Accelerator6666/Yaesu-FT2D-USBC-charge/hardware/Rev_B/README.md

# FT2D PCB Rev B（JLCPCB 首板工作版，未放行）

检查日期：2026-10-26；KiCad 10.0.7；目标板厂：嘉立创 JLCPCB；目标工艺：4 层 PCB + SMT 代贴片。

> **规则检查已清零，但制造仍 NO-GO。** 本目录可在 KiCad 10 打开；J1/L1 换料、C18 新候选的焊盘调整、GND 回流布线、局部功率铜、U3 四颗标准过孔及 In2 两个局部功率铜岛均已同步，全部 DRC/Parity 通过。**53/53 个 SMT 位号已匹配候选 LCSC 编码，37 种物料均未正式获批**。剩余 3 A 功率/散热审查、JLC 实际供料/兼容性、元器件和装配方向签核尚不能省略。

## 当前可复现检查

```sh
kicad-cli sch erc --format json -o erc_rev_b.json FT2D_PD20V_12V5_3A_评审原理图.kicad_sch
kicad-cli pcb drc --schematic-parity --refill-zones --format json -o drc_rev_b.json FT2D_PD20V_12V5_3A_评审原理图.kicad_pcb
```

| 检查 | 实际结果 | 说明 |
| --- | --- | --- |
| 原理图 ERC | **0** | 仅表示静态 ERC 通过 |
| 异网短路 / 铜间距违规 | **0** | KiCad 本次静态规则检查未发现硬性违规 |
| DRC violations | **0** | U1 已用系统库相同 29 焊盘封装刷新；局部无效热焊盘连接已处理 |
| DRC unconnected | **0** | 独立顶层 GND 区域通过常规穿孔过孔与内层地面连接，C5 补上局部 GND 逃线 |
| schematic parity | **0** | PCB 与当前 Rev B 原理图一致；DNP 设置同步 |

上述结果按此目录所附 `erc_rev_b.json` 和 `drc_rev_b.json` 为准。**规则检查 0/0/0/0 不是 3 A 载流能力、PD 功能、贴片方向或安全性能的认证。**

## 本轮已核对并替换的 JLC 物料

| 位号 | 新器件及嘉立创料号 | 原厂/焊盘验证 | 装配保留事项 |
| --- | --- | --- | --- |
| **J1** | HRO `TYPE-C-31-M-12`，**C165948** | 标称 **20 V / 5 A**；KiCad 10 标准 `Connector_USB:USB_C_Receptacle_HRO_TYPE-C-31-M-12`；按产品引脚表保持 CC1/CC2、VBUS、GND 网络，中心 `(24.15,42)`，转角 `-90°` | 立创标为 SMT，但带 **4 个穿孔屏蔽固定脚**；必须由 JLC 订单预览确认这种混合结构可贴装及固定脚焊接方式，并确认板边插拔可达性 |
| **L1** | JIERR `SRG1260-100-M`，**C53463013** | **10 µH ±20%**，Isat **14 A typ**，Idc **11 A typ**，DCR **25 mΩ max**；原厂落地尺寸 14.6 mm 总跨距、7.4 mm 焊盘间隙、4.8 mm 焊盘高度，生成 `FT2D:JIERR_SRG1260_100M`；器件高度 **6 mm max** | 数据表只是额定能力，不是开关纹波/温升实测；尤其要确认电台安装净高 |
| **C18** | Panasonic `EEH-ZA1V470P`，**C178639** | 35 V / 47 µF 混合铝电容，**60 mΩ @100 kHz、1.3 A @100 kHz**；与原 EEH-ZL1V470R 的 **60 mΩ** 指标一致；PCB/C18 的封装改为 KiCad `CP_Elec_6.3x5.8`，中心由 `(62,48)` 移至 `(61.5,48)`，保持 pad 1=`/VBUS_SW`、pad 2=`/GND`；替代后 ERC 0、DRC 0、Parity 0 | **温度由原 135°C 降为 105°C**（虽是 10000 h @105°C）；须复核实际环境和热裕量、极性、焊盘尺寸及库存；不能据此自动批准 SMT |

J1 原厂 [PDF](https://datasheet.lcsc.com/datasheet/pdf/9e56b777c022540fcce7c7f67825f55e.pdf?productCode=C165948)，L1 原厂 [PDF](https://datasheet.lcsc.com/datasheet/pdf/970397481256e0f4304d2971057c0f55.pdf?productCode=C53463013)。立创供料库存会变化，投单时须再次确认。

## 主要阻止打板的问题（按优先级）

1. **3 A 功率铜尚未签核**：顶层沿 `/USB_VBUS`、`/VBUS_RAW`、`/VBUS_SW`、`/SW`、`/V12P5`、`/VOUT` 增加 **1.6–2.0 mm 目标宽度**的合并局部铜皮，但异网净距会裁切狭颈；原细线最小仍为 **0.25–0.60 mm**。本轮按照 TI eFuse IN/OUT 加铜和散热过孔建议，在 `In2.Cu` 增加 `/V12P5` **51.54 mm²** 和 `/VOUT` **55.29 mm²** 互不接触的局部铜岛，每网两颗 **0.6/0.3 mm 普通过孔**；两岛均连续并通过 DRC。U3 Pin 5/6 仍存在约 **0.3 mm** 短逃线，**不能宣称全线按 3 A 等效宽度连通**。需复查各路径最窄断面、过孔电流、内层地回流、压降与满载升温。
2. **BUCK 高频布局仍待复核**：U2 `(79,43)`，L1 SW 端 `(83.5,43)`，直距约 **3.7 mm**；输入 C12/C13 高频去耦位置、U2 VIN/PGND 回路、输出电容接地/反馈 Kelvin 路径都须按照 TI 指南审查，SW 追踪铜面积仍可能引入 EMI。
3. **JLC 候选编码齐备，采购/装配未签核**：53 个非 DNP SMT 位号已有 37 个候选 C-code，本地 BOM/CPL 静态比对全通过。**这不等于 JLC SMT 供料实时有货、同外形即可直接替代，或可下单**。F1 `C41342`、C18 `C178639`、C23 `C46550464` 温度/ESR 降额需确认；**R22 已由 101 kΩ 改为嘉立创标注 SMT 的 102 kΩ / `C861068`**，OVLO 标称阈值约从 13.32 V 变为 13.44 V，实际误差/瞬态仍须验证；**C26 已从 100 nF/25 V 改为 2.2 µF/25 V/0603 X7R 候选 `C415535`，但实际 12.5 V DC bias 后容值需核对**；其他 1210 MLCC 需核实 DC 偏压有效电容，0.1% 电阻需复核实际规格；J1 混合 SMT/通孔固定脚需要装配商确认。
4. **SMT 机器贴装仍未确认**：53 个位置与 PCB 坐标已通过本地审计，但 HRO J1 `-90°`、异形功率器件方向、极性电容、贴片取放中心及 KiCad Y 轴符号必须在 JLC 预览中人工核对。
5. **功能级风险**：STUSB4500 NVM 需编程并验 20 V PDO；eFuse 限流、DC-DC 环路、输出线束电台端极性、热和射频噪声尚无实测。

**新增定量初筛（仍未签核）**：按照 PCB 当前 U3 Pad 5/6 和 35 µm 标称顶铜，假设整段 0.2998 mm 原走线独自承载 3A，分别在 90°C 得到约 **54 mW（2.85 mm 输入）/28 mW（1.49 mm 输出）**的铜阻损耗模型值；实际上 pad 与同网铜区有重叠和并联，若实板铜厚偏低或温度更高损耗还会增加，此算法不能计算温升。U3 典型 28.3mΩ R_ON 在 3A 下自身耗散约 **0.255W**，R26=820Ω 按 TI 典型公式电流门限约 **4.07A**，必须用热测、过流试验核查。自动初筛脚本 `../../engineering_tools/screen_rev_b_power_path.py` 以及结果 `../../manufacturing/Rev_B/PREFLIGHT/power_path_screening.json` 可复现。**STUSB4500 出厂 PDO3=20V/1A，且 `POWER_ONLY_ABOVE_5V=0`，不是本项目所需 20V/3A**；详见 `../../manufacturing/Rev_B/PD_NVM_AND_FIRST_POWER_ON_PLAN.md`。可先使用 `../../manufacturing/Rev_B/QUOTE_PREVIEW_ONLY_NOT_RELEASED/` 作 JLC 在线报价/贴装预览，**不可当作正式放行**。

## 已完成的布线/设计动作

- 原评审 PCB 不变；此目录保留 Rev B 的独立原理图、PCB、工程设置和封装库。
- 保持 `POWER_REV_B` netclass 0.6 mm 路由过渡值，同时用 `power_pours_rev_b.py` 增加局部宽铜；**铜宽仍需实体连续性和发热签核**。
- 用两个新物料封装替换 J1/L1，并将 U2 SW 与 L1 SW 缩至约 3.7 mm；全部原走线重建并验证无异网硬短路。
- 已修复 U1 KiCad 系统库封装不一致告警；优先以常规 **0.6/0.3 mm GND 穿孔过孔**保留回流通路，再全板重布线。U1/U2/R25/R26 周边地与 C5 局部地均已接通，未使用未签核的焊盘盲埋孔。GND 特殊热焊盘局部改为实体连接；全板 DRC **0 违规 / 0 未连接**。
- 把两段自动布线占用 `In1.Cu` GND 参考面的 `/VBUS_SW` 导线转到 `In2.Cu`，避免在 Buck 下方切割连续地平面；重新填铜验证 0/0。
- C18 替换候选 Panasonic C178639 的直径更大，PCB/原理图/符号库同步换成 6.3×5.8 mm 封装，左移 0.5 mm 消除 `/BUCK_VCC` 净距冲突；极性和所有静态规则再次通过。**105°C 温度等级待确认**。
- U3 TPS259474A 的 `/V12P5` 和 `/VOUT` 各加 2 颗常规 0.6/0.3 mm 穿孔并连入 In2 局部功率铜皮（`add_u3_power_stitch_rev_b.py`）；分别提供约 **51.54 / 55.29 mm²** 内层扩散面积，远离现有 In1 模拟反馈/ILM 走线，局部形状/孔距经隔离试板迭代到 DRC0。**新增铜不等于已完成 3 A 温升/EMI 验证。**
- 根据 TI TPS25947 的 OUT 端建议把 **C26 从 100 nF/25 V 升级为 2.2 µF/25 V X7R 0603**，Murata 候选 `GRM188Z71E225KE43D` / `C415535`，原 PCB 0603 pad 保持不变，原理图/符号库/原生 BOM/JLC 候选清单同步；偏压有效容值和取放/库存待审。
- **修复贴片坐标漏项**：将 L1、Q1、U2、U3、D1 自定义封装标为 `attr smd`；C11/R14 DNP 排除，实际预览 CPL 为 **53 个位置**。
- 原理图和 PCB 的 DNP 与 BOM 属性一致，PD 协商和电台输出的电气定义未修改。

可审计工具在 `../../engineering_tools/`；未通过 DRC 的局部接地布线实验已从 PCB 与提交文件中移除。

## 投板门槛

- [ ] 全面优化 U2–L1–电容功率环路，宽铜/铜皮与热设计通过工程复核。
- [x] ERC 0、DRC 0 实质违规、**DRC 0 未连接**、Parity 0（KiCad 10.0.7）；工程复查仍另计。
- [ ] U1、U2、U3、Q1、J1、L1 的封装与厂家 land pattern 对照签核。
- [x] **候选** JLC/LCSC 料号覆盖 53/53 SMT 位号；DNP C11/R14、人工工序 J2/J3 不入 SMT BOM/CPL；本地 BOM/CPL 结构检查通过。
- [ ] 53/53 候选编码逐项确认 JLC 实时 SMT 可贴装/有货、原厂物料与焊盘匹配；在线 SMT 预览方向及极性正确，才能生成 `BOM_APPROVED.csv` / `CPL_APPROVED.csv`。
- [ ] PD NVM 烧录工装、12.5V 无电台电子负载测试计划完备。

`../../manufacturing/Rev_B/REVIEW_ONLY_NOT_FOR_FAB/` 提供 **57 行原生 BOM、53 行 CPL、53 行候选 JLC BOM/坐标、供料追溯表、供料工作簿、顶层/In2 铜预览图和随本轮板文件重新导出的全部 Gerber/Excellon 钻孔 QA 文件**，这些均是**审阅版，不能直接下单**。`export_jlcpcb_release_rev_b.sh` 的静态检查已通过，但正确地停在**没有完整签核 BOM/CPL/工程签字**的下一道门禁。**正式 RELEASE_READY 制造包未生成。**

## 关键一手资料

- [JLCPCB KiCad 10 BOM / Pick-and-Place 指南](https://jlcpcb.com/help/article/how-to-generate-the-bom-and-centroid-file-from-kicad)
- [ST STUSB4500](https://www.st.com/resource/en/datasheet/stusb4500.pdf)
- [TI LM61460-Q1](https://www.ti.com/lit/ds/symlink/lm61460-q1.pdf)
- [TI TPS25947](https://www.ti.com/lit/ds/symlink/tps25947.pdf)
