Accelerator6666/Yaesu-FT2D-USBC-charge/FAB_READINESS.md

# FT2D USB-C PD 电源板：首板投板准备评审

检查日期：2026-10-25  
工程版本：GitHub `main` 上的原始评审 PCB（KiCad 10.0）  
**结论：NO-GO，当前文件不能作为制造放行依据。**

本报告聚焦「尽快制作安全的工程样板」所需的设计/制造门槛。原始原理图、布局、自动布线 PCB 都保留；本报告不宣称完成电气功能验证，也不生成可下单 Gerber。

## 1. 可复现的 KiCad 检查

在安装了 KiCad 10.0.7 的环境里运行：

```bash
kicad-cli sch erc --format json -o erc.json 'FT2D_PD20V_12V5_3A_评审原理图.kicad_sch'
kicad-cli pcb drc --schematic-parity --format json -o drc.json 'FT2D_PD20V_12V5_3A_评审原理图.kicad_pcb'
```

实际结果：

| 检查 | 结果 | 判断 |
| --- | --- | --- |
| 原理图 ERC | 0 项违规 | 通过该项静态检查，但不代表电路可安全运行 |
| PCB DRC | 7 项违规（其中 1 项为封装库不一致警告） | 不通过 |
| PCB 未连接项 | 3 项 | 不通过 |
| 原理图/PCB 一致性 | 5 项属性差异 | 需处理或经审核明确接受 |

PCB DRC 违规分类：3 项不同网络短接、2 项铜箔间距不足、1 项阻焊桥接、1 项 U1 封装与本机 KiCad 10 官方库不一致。注意这些项目有相关性，不能简单理解为七个独立根因。

重点位置：

- `U3` 附近：`OVLO_U3` 路由与 `UVLO_U3` 路由/过孔相碰；两条保护信号被误连。
- `R22` 附近：`OVLO_U3` 与 `V12P5` 铜线短接，同时 R22 的 OVLO 端存在未连接提示；该区域还有阻焊桥接。
- GND 铺铜：DRC 额外列出两处不连续的地铜岛，需判断是应删除的孤岛还是应以过孔连接的回流区域。
- 5 项属性差异：C11、R14 的 DNP/BOM 属性，以及 TP1 的 BOM 属性（原理图与 PCB 不一致）。

## 2. 3 A 功率路径明显不足

对现有 PCB 的全部 382 条 `segment` 逐项解析，得到：

| 网络 | 已有布线宽度 | 备注 |
| --- | --- | --- |
| `USB_VBUS` | 0.20 mm | USB-C 入口至保险丝 |
| `VBUS_RAW` | 0.15 / 0.20 mm | 保险丝后母线、PD 供电 |
| `VBUS_SW` | 0.20 mm | Q1 至 U2 及输入电容 |
| `SW` | 0.20 mm | U2 开关节点至 L1 |
| `V12P5` | 0.20 mm | 降压输出至 eFuse 和负载分支 |
| `VOUT` | 0.20 mm | eFuse 至输出线束焊盘 |

目前不能仅把这些线统一改宽：保护芯片的细间距引脚、附近信号线和过孔已很密集；不重新布局就扩宽会引起更多短接和间距问题。应对 J1/F1、Q1、U2、L1、U3、J3 的主要电流路径进行连续宽铜/铜皮和必要的并联过孔设计，并核查最大工作温升及线束压降。

简单的铜电阻数量级参考：35 µm 厚、0.20 mm 宽、100 mm 长的铜线，20°C 理论直流电阻约 **0.25 Ω**，在 3 A 时压降约 **0.75 V**、损耗约 **2.25 W**。这只是横截面与长度的演算例子，不代表板上任意完整支路都恰好长 100 mm；实际载流与温升还受铺铜、层叠、并联路径、散热和工艺影响。

## 3. 需要进一步工程确认

1. **PCB 功率环路**：把 U2 的输入高频去耦贴近 VIN/PGND；缩小 U2–L1–输出电容回路；FB 远离 SW，Kelvin 取样。现有器件位置应重新评审。
2. **封装核对**：尤其是自绘的 LM61460-Q1（RJR）、TPS259474A（RPW）、Q1（PowerFLAT）、L1、USB4085-GF-A，按制造商 land pattern 核对焊盘编号、开窗和尺寸；U1 库不一致警告不得简单忽略。
3. **电气参数**：复核 STUSB4500 所需 NVM 配置及 I²C 2.7 V 编程接口；核算 DC-DC 稳定性、输入电容直流偏压有效容量、eFuse OVLO/ILM 公差，以及启动/关断瞬态。
4. **输出线束**：核实原厂 Yaesu E-DC-6 机械尺寸与极性，并量测满载电台端电压。
5. **制造工艺**：确定板厂、4 层叠层、铜厚、最小线宽/间距、阻焊桥、过孔孔径及是否代贴片；据此设置 KiCad 约束并校验 Gerber/钻孔。

## 4. 建议执行顺序（最短安全路径）

1. 保留当前评审版，另建 `PCB Rev B`，围绕功率链重排元件并重新设计信号扇出与回流路径。
2. 修复所有实质短接/未连接，消除或逐项审定封装库与属性差异，完成 PCB ERC/DRC 与原理图一致性检查。
3. 独立核对封装和板厂规则，再生成四层 Gerber、阻焊、丝印、Excellon 钻孔及含封装编号的 BOM；对自动/手工焊接工艺分别准备所需文件。
4. **只投工程样板**，不接 FT2D：先用 PD 分析仪确认 20 V/3 A 协商及错误电源拒绝行为，再用电子负载验证 0–3 A、阶跃、短路、过压、纹波、板温和射频噪声。
5. 电子负载测试通过、线束极性确认后，才分步骤接真实电台测试。

## 5. 需要确认的制造偏好

- 板厂（例如嘉立创 JLCPCB / PCBWay / 其他）；
- 仅裸 PCB 自行焊接，还是需要 SMT 代贴片；
- 希望首先验证电源功能，还是同时追求缩小板尺寸。

这些选择决定封装可采购性、BOM/CPL、板尺寸和制造约束；若追求首板尽快验证，建议优先功能和可焊接性，暂缓极限小型化。

## 一手资料

- [KiCad 10 CLI / DRC / Gerber 指南](https://docs.kicad.org/10.0/en/cli/cli.html)
- [STUSB4500 数据表](https://www.st.com/resource/en/datasheet/stusb4500.pdf)
- [LM61460-Q1 数据表](https://www.ti.com/lit/ds/symlink/lm61460-q1.pdf)
- [TPS25947 数据表](https://www.ti.com/lit/ds/symlink/tps25947.pdf)
- [STL6P3LLH6 数据表](https://www.st.com/resource/en/datasheet/stl6p3llh6.pdf)
- [Bourns SRP1238A 数据表](https://www.bourns.com/data/global/pdfs/SRP1238A.pdf)
- [GCT USB4085 产品页](https://gct.co/connector/usb4085)
