Accelerator6666/Yaesu-FT2D-USBC-charge/FT2D_PD20V_12V5_3A_原理图连接表.md

# FT2D USB-C PD 外接直流电源：电气原理图连接表（Rev A）

**状态：工程评审稿，不能直接投板。** 本文件给出逐引脚电气连接、阻容初值及 PCB 约束；它不是已完成的 KiCad/JLCEDA 原理图、PCB、Gerber 或实测合格证明。正式投板前须把连接表录入 EDA，做 ERC/DRC、封装对照与评审。首板只接电子负载，不接 FT2D。

## 规格和边界

- 功能：把 USB-C PD 固定 20 V / ≥3 A 转为 12.5 V / 3 A 连续的外接直流电源。FT2D 内部决定电池充电电流，本板不是锂电池充电管理器。
- FT2D 手册外接电源要求：**12–14 V，≥3 A**。电台端使用原厂 E-DC-6 尾线或实测兼容插头；不在未核实机械尺寸、中心极性前指定直流插头封装。
- 只支持真正具有 20 V / 3 A 固定 PDO 的 PD 电源与 3 A C-C 线；5 V、9 V、15 V 以及 20 V / 2.25 A 不应接通负载。
- 设计目标是插头处 3 A 时仍有 ≥12.0 V。12.5 V 名义值给出的理论上限是 0.167 Ω，但考虑反馈/基准公差后，首板把板端到插头的总串联电阻定为 **≤0.10 Ω**，并以实测插头电压验收。
- 本设计采用 STUSB4500QTR、STL6P3LLH6、LM61460-Q1、TPS259474ARPWR。**STUSB4500 的 NVM 必须在首次上电带负载前正确烧录并读回**，出厂默认值不满足本设计。

## 网名

`GND`、`VBUS_RAW`（USB 口经 F1 后）、`PD_GATE`、`VBUS_SW`（Q1 后）、`SW`（U2 开关节点）、`V12P5`（降压输出 / eFuse 输入）、`VOUT`（eFuse 后、去电台）、`CC1`、`CC2`、`PD_2V7`、`PD_1V2`、`EN_U2`、`FB_U2`、`UVLO_U3`、`OVLO_U3`、`ILM_U3`、`ITIMER_U3`、`DVDT_U3`、`PGTH_U3`、`SCL`、`SDA`。

## 1. USB-C 和 PD 协商

| 器件/引脚 | 连接 | 说明 |
| --- | --- | --- |
| J1 GCT USB4085-GF-A，A4/A9/B4/B9 | 经 F1 至 `VBUS_RAW` | 四个 VBUS 脚并联，走宽铜；F1 初选 Littelfuse `1206SFS300F/32`，3 A / 32 V 慢断，核对温度降额和启动浪涌。 |
| J1 A1/A12/B1/B12、外壳 | `GND` | 外壳接地方案与 ESD 布局须审核；不要把 CC 接地。 |
| J1 A5、B5 | 分别至 `CC1`、`CC2` | CC1/CC2 独立布线，靠近接口放 ESD 保护。USB 2.0 D+/D−、SBU 留空；不要短接两根 CC。 |
| U1 STUSB4500QTR 1/2 | `CC1` | CC1DB 与 CC1 相接，启用 dead-battery Rd。 |
| U1 4/5 | `CC2` | CC2 与 CC2DB 相接。 |
| U1 3 | NC | 不连接。 |
| U1 6 RESET | R1 10 kΩ 到 `GND`；留测试点 | 复位为高有效；测试点可由 2.7 V 逻辑驱动。 |
| U1 7 SCL、8 SDA | 各用 R2/R3 4.7 kΩ 拉至 `PD_2V7`；连 J2 编程焊盘 | 编程器只能使用 2.7 V 兼容的 I²C 电平，不可直接上 5 V。 |
| U1 9 DISCH | 经 R4 1 kΩ 至 `VBUS_SW` | PMOS 下游电容放电；上电实测放电时序。 |
| U1 10、裸露焊盘 | `GND` | 裸露焊盘按 ST 推荐开窗、过孔接地。 |
| U1 11 ATTACH、14 POWER_OK3、15 GPIO、17 A_B_SIDE、19 ALERT#、20 POWER_OK2 | 留空或仅测试点 | 这些输出不用作电源联锁。 |
| U1 12 ADDR0、13 ADDR1、22 VSYS | `GND` | 无 MCU；I²C 编程接口仍可用。 |
| U1 16 VBUS_EN_SNK | R5 22 kΩ 至 `PD_GATE` | 开漏；NVM 设为仅 PDO2/3 合约接通。 |
| U1 18 VBUS_VS_DISCH | 经 R6 470 Ω 至 `VBUS_RAW`；C5 1 µF / 25 V 对地 | 原边 VBUS 电压监测/放电，按 ST 参考电路。 |
| U1 21 VREG_1V2 | `PD_1V2`，C1 1 µF / 6.3 V 至地 | 仅去耦，不作外部电源。 |
| U1 23 VREG_2V7 | `PD_2V7`，C2 1 µF / 6.3 V 至地 | 给 I²C 4.7 kΩ 上拉；外部编程器不得向此网反灌电流。 |
| U1 24 VDD | `VBUS_RAW`，C3 1 µF / 25 V 至地 | 该电容靠近 U1。 |
| Q1 STL6P3LLH6 源极 1/2/3 | `VBUS_RAW` | P 沟道高边开关。 |
| Q1 栅极 4 | `PD_GATE` | R7 100 kΩ 至源极；C4 47 nF / 50 V 至源极，用作浪涌斜率初值，首板验证热插拔/掉电时序。 |
| Q1 漏极 5/6/7/8 | `VBUS_SW` | Q1 栅源压在 20 V 时约 −16.4 V（22 kΩ/100 kΩ 分压），小于 ±20 V 额定；核实实际驱动波形。 |
| J2 编程焊盘 | 1=`GND`、2=`SCL`、3=`SDA`、4=`PD_2V7` 测量用、5=`VBUS_RAW` 测量用、6=RESET | 板上给 U1 供电时编程；J2 的 4/5 脚不可作为对外供电输出。 |

USB 口附近由 D1 `ESDA25P35-1U1M` 保护 J1 侧 `USB_VBUS` 至 `GND`（D1 1 脚接 USB_VBUS、2 脚接地，位于 F1 前），D2 `ESDA25W` 的两通道分别保护 `CC1`、`CC2` 至 `GND`（D2 1/2 脚分别接 CC1/CC2、3 脚接地）；按 ST 数据表与封装图逐项核实二极管方向和脚位，不可只凭器件名摆放。ESD 器件不是持续 20 V 过压保护。F1、ESD、USB 母座的接地回路要最短。

U1 NVM 烧录项目：`SNK_PDO_NUMB=2`；PDO1=5 V（仅协商/芯片供电，电台侧被断开）；PDO2=20 V / 3.0 A；`POWER_ONLY_ABOVE_5V=1`；`REQ_SRC_CURRENT=0`。把 PDO3 禁用。烧录后读回、断电重启，再用 PD 分析仪确认 RDO 为 20 V / 3.0 A；20 V / 2.25 A 电源不能使 `VBUS_EN_SNK` 导通。

## 2. 20 V → 12.5 V 同步降压

U2 选 **LM61460AASQRJRRQ1**（Auto 模式、扩频、可调频率/输出），4.0 × 3.5 mm RJR/VQFN-HR 封装，订货时核对后缀与引脚。400 kHz 设计初值如下。

| U2 引脚 | 连接 | 外围 |
| --- | --- | --- |
| 1 BIAS | `GND` | **12.5 V 输出高于 12 V，数据表要求 BIAS 接地**，不能接 `V12P5`。 |
| 2 VCC | C10 1 µF / 16 V 至 U2 AGND | 不挂其它负载。 |
| 3 AGND | `GND` | 与两个 PGND 在连续地平面相连；反馈电阻接 AGND。 |
| 4 FB | `FB_U2` | R12 100 kΩ / 0.1% 从 `V12P5` 至 FB；R13 8.66 kΩ / 0.1% 从 FB 至 AGND。名义输出 `1×(1+100/8.66)=12.547 V`；留 C11 10 pF + R14 1 kΩ 串联跨 R12 的 DNP 调试位。 |
| 5 PGOOD | TP_PGOOD，R15 100 kΩ 至 U2 VCC | 仅测试；不作为输出额定保障。 |
| 6 RT | R16 33.2 kΩ / 1% 至 AGND | 400 kHz 标称。 |
| 7 EN/SYNC | `EN_U2` | R17 133 kΩ / 1% 自 `VBUS_SW` 至 EN；R18 10 kΩ / 1% 自 EN 至 AGND。上升启机名义 18.06 V；与 U1 合约联锁共同防止 5/15 V 启动。 |
| 8 VIN1、12 VIN2 | `VBUS_SW` | VIN1/PGND1 和 VIN2/PGND2 各紧贴一只 100 nF / 50 V X7R（C12/C13）。两组附近总 4×10 µF / 50 V X7R（C14–C17），须核对 20 V 直流偏压后的有效总容量 ≥10 µF。另加 C18 Panasonic `EEHZL1V470R`，47 µF / 35 V、ESR 60 mΩ max 作输入阻尼。 |
| 9 PGND1、11 PGND2 | `GND` | 先闭合两条最短高频电流环，再并入地平面。 |
| 10 SW | `SW` | 接 L1 一端与 CBOOT 回路。SW 铜面积只够承流，不要在其下布 FB/CC。 |
| 13 RBOOT | 经 R19 0 Ω 至 CBOOT | EMI 预留 22–100 Ω 替换验证位，首装 0 Ω。 |
| 14 CBOOT | C19 100 nF / 16 V X7R 至 `SW` | 靠近 U2。 |

L1 另一端接 `V12P5`，初选 **Bourns SRP1238A-100M：10 µH、I_sat 14 A、I_rms 7 A、DCR 34 mΩ max**，按该型号推荐焊盘绘制封装。20 V→12.5 V、400 kHz 下纹波约 1.17 A 峰峰值；按 TI 的保守要求，I_sat 高于 U2 的 11.5 A 高边极限。实际环路稳定性和温升仍须首板验证。

`V12P5` 对地：C20/C21/C22 各 47 µF / 25 V X7R（核对直流偏压和纹波）；C23 初选 APAQ `250AVHT221M0608`，220 µF / 25 V、ESR 24 mΩ max 聚合物电容（注意其 ESR 零点，首装不装 C11/R14 前馈）。C24 100 nF / 25 V 贴近 U3 输入。上述电容要满足 U2 稳定性而不仅是总标称 µF；首板用 0↔3 A 阶跃看是否振荡/过冲。

## 3. 输出过压/过流与 FT2D 线束

U3 为 **TPS259474ARPWR**，RPW 2×2 mm QFN-10，电路断路器、可调过压关断、自动重试版本；不要替换为 TPS259472（钳位型）。

| U3 引脚 | 连接 | 外围/设计值 |
| --- | --- | --- |
| 1 EN/UVLO | `UVLO_U3` | R20 470 kΩ 从 `V12P5` 至该脚；R21 100 kΩ 从该脚至地。12.5 V 时约 2.19 V，低于该脚 5 V 建议上限。 |
| 2 OVLO | `OVLO_U3` | R22 101 kΩ / 1% 自 `V12P5` 至该脚；R23 10 kΩ / 1% 至地；标称关断约 13.32 V。阈值/电阻公差及漏电下的范围须在首板扫压测得，保证不在正常输出误动作且异常时电台插头不超过 14 V。 |
| 3 PG | TP_PG（不接负载） | 开漏状态输出，未用时不强制上拉。 |
| 4 PGTH | `PGTH_U3` | R24 100 kΩ 从 `V12P5` 至该脚；R25 12 kΩ 至地；约 11.2 V 时判为 PG，供 TP_PG 诊断。 |
| 5 IN | `V12P5` | 接 C24。 |
| 6 OUT | `VOUT` | C25 47 µF / 25 V、C26 100 nF / 25 V 至地，位于 U3 后；输出连接器接此网。 |
| 7 DVDT | `DVDT_U3` | C27 3.3 nF / 25 V 至地，限制启动斜率；首板测浪涌。 |
| 8 GND | `GND` | 按 TI 2×2 mm 焊盘与散热布局。 |
| 9 ILM | `ILM_U3` | R26 820 Ω / 1% 至地；标称 `3334/820=4.07 A`，考虑器差后仍需保证 3 A 不误跳。 |
| 10 ITIMER | `ITIMER_U3` | C28 2.2 nF / 10 V 至地；约 1.85 ms 过流消隐初值，实测发射负载阶跃。 |

校核值：R22/R23 与 U3 阈值公差组合，忽略引脚漏电时的过压关断约 **12.895–13.825 V**；U2 名义设定约 12.547 V。漏电、瞬态、纹波与电容放电可影响实际最高插头电压，故不能只靠此静态计算判定电台安全。

J3 是两个大焊盘/压线端子：`VOUT` 和 `GND`，焊接 E-DC-6 原厂尾线。J3 丝印必须同时标 `+12.5V` 和 `GND`；在确认原厂尾线与电台实际极性之前**不能把 J3 与 FT2D 相连**。建议线束短于 0.5 m、两芯各 ≥0.75 mm²，实际以 3 A 插头处压降和温升验收。输出带反灌阻断，但不能依赖它纠正线束反接。

## 4. PCB 布局和投板门槛

建议四层、1 oz 外层铜：L1 器件/功率，L2 整面地，L3 VBUS/V12P5 辅助功率，L4 信号/地；尺寸以 13.5 mm 方形 L1 和 USB 母座机械图确定，初估 ≥55×40 mm。3 A 主路径尽量用整片铜与并联过孔，不靠单根细线；开关节点不走内层长线。CC1/CC2 远离 L1/SW；FB 从 C20–C23 的输出端 Kelvin 取样，不在电感或负载焊盘上取样；输入 100 nF 必须紧贴两组 VIN/PGND。U3 的 OVLO 电阻靠近 U3，避免 SW 噪声串入。连接器机械脚、插拔应力、散热与极性丝印逐项核对。

**下单前必须完成：**

1. 对照四个 IC、USB 母座、Q1、L1 的官方封装图核 pin 1、焊盘、禁布区；KiCad/JLCEDA ERC 无未解释错误，PCB DRC 无未解释错误。
2. 生成并复查全部铜层、阻焊、丝印、板框 Gerber 及 Excellon 钻孔；用独立 Gerber 查看器确认电源焊盘、USB 母座、孔径和外形。
3. 检查真实可购买物料、直流偏压电容有效容值、F1 熔断曲线、Q1 栅极驱动/浪涌、U2 稳定性、U3 阈值误差。STUSB NVM 烧录方式和工具在订单前备好。
4. 首板只接电子负载：先 5/15/20 V PD 拒绝/接受测试，再 0/1/2/3 A 热、纹波、插头压降、启动/掉电/短路/输出过压测试；确认 144/430 MHz 接收底噪无不可接受的开关噪声；最后才接电台。

## 官方资料

- [Yaesu FT2DR/DE 操作手册](https://yaesu.com/Files/DFDF4D53-1B78-7375-E6C7A6E4B192BE13/FT2DR_DE_EH060M203_1608Y-EM-1.pdf)
- [STUSB4500 数据表，图 9 为最小实现](https://www.st.com/resource/en/datasheet/stusb4500.pdf)
- [STL6P3LLH6 数据表](https://www.st.com/resource/en/datasheet/stl6p3llh6.pdf)
- [LM61460-Q1 数据表，第 10 节为设计流程](https://www.ti.com/lit/ds/symlink/lm61460-q1.pdf)
- [TPS25947 系列数据表](https://www.ti.com/lit/ds/symlink/tps25947.pdf)
- [Bourns SRP1238A 系列数据表](https://www.bourns.com/docs/product-datasheets/srp1238a.pdf)
