Accelerator6666/Yaesu-FT2D-USBC-charge/FT2D_USB-C_PD_3A_设计说明.md

# FT2D USB-C PD 外接电源适配器：3 A 版设计说明

状态：电气方案初稿，尚未完成原理图、PCB、样机测试。此适配器向 FT2D 的 `EXT DC IN` 提供直流电；电池充电过程仍由电台内部管理。

## 1. 设计目标

| 项目 | 目标 |
| --- | --- |
| 电台端工作电压 | 12–14 V，拟定模块输出 12.5 V；在 0–3 A 时以电台插头处实测值为准 |
| 连续输出电流 | 至少 3 A |
| 短时过流保护 | 输出电子断路器约 4 A，实际阈值按器件公差和样机实测确定 |
| USB-C 电源 | 必须提供 USB PD 固定 20 V、至少 3 A，额定功率至少 60 W |
| 失配电源 | 仅有 5 V、9 V、15 V 或 20 V 电流不足 3 A 时，不向电台供电 |
| 接口 | 电台侧采用 Yaesu E-DC-6 兼容插头，优先使用原厂尾线确认机械尺寸和极性 |

Yaesu FT2DR/DE 手册规定外接电源 12–14 V，供电能力至少 3 A；电源不足时发射可能掉压。该手册也指出原配慢充适配器不适合边充边收发。提高适配器的电流容量不会提高电池充电电流，也不保证缩短原先约 9 小时的充电时间。

## 2. 功率链

```text
USB-C 母座（20 V / 3 A PD）
    │
    ├─ CC1/CC2 → STUSB4500 协商，仅设 5 V 必备档和 20 V / 3 A 工作档
    │                   │
    └─ VBUS → 受 VBUS_EN_SNK 控制的高边 PMOS → 20 V 母线
                                              │
                                              ├─ 输入去耦、ESD/浪涌保护
                                              │
                                              └─ LM61460-Q1 同步降压 → 12.5 V
                                                                        │
                                                                        └─ TPS259474A 电子断路器
                                                                             ├─ 约 4 A 过流断开
                                                                             ├─ 约 13.3 V 过压断开
                                                                             └─ 输出滤波 → Yaesu 插头
```

20 V × 3 A = 60 W。12.5 V × 3 A = 37.5 W。即便按 85% 效率估算，所需输入功率约 44.1 W，在 60 W PD 电源之内。USB-C 线选明确标为 60 W / 3 A 的 C-C 线；3 A 不需要 5 A 电子标记线。

## 3. 关键器件和设置

| 位置 | 推荐器件/参数 | 原因与待验证项 |
| --- | --- | --- |
| PD 受电控制器 | STUSB4500 | 可在无 MCU 情况下从 NVM 设定受电 PDO，并用 `VBUS_EN_SNK` 控制高边 PMOS。必须先烧录 NVM、读回、断电重启验证；出厂默认参数不能直接使用。 |
| STUSB4500 NVM | `SNK_PDO_NUMB=2`；PDO1 为必备 5 V；PDO2 为 20 V / 3 A；`POWER_ONLY_ABOVE_5V=1`；`REQ_SRC_CURRENT=0` | 只有 20 V / ≥3 A 合约成功才接通 PMOS；仅有 15 V 或 20 V/2.25 A 的电源不能供电。 |
| 输入高边开关 | 按 STUSB4500 官方最小实现电路选型的 PMOS，建议 ≥30 V、≥6 A 器件级额定值 | 验证启动浪涌和接通时的器件温升；不能省略 ST 官方推荐的栅极外围和 VBUS 检测滤波。 |
| 降压器 | TI LM61460-Q1，6 A 级，输出设 12.5 V | 具有扩频、可调开关边沿及同步整流；电感、电容、补偿/前馈与频率须按数据表和板级测试确定。 |
| 输出电子断路器 | TI TPS259474ARPWR | 可调过压关断、可调过流断路器、自动重试、反向电流阻断。上一版 TPS259621 最高 2 A，不再适用。 |
| TPS259474A 电流门限 | 标称约 4 A；`R_ILM ≈ 3334 / 4 = 834 Ω`，820 Ω 为待验证初值 | 门限有公差，持续 3 A 不得误断；输出短路或过载时须可靠切断。 |
| TPS259474A 过压门限 | OVLO 分压初值：上臂 101 kΩ、下臂 10 kΩ，均 1%；标称约 13.3 V | 依据数据表的 1.183–1.223 V OVLO 阈值，忽略引脚漏电时预计约 12.9–13.8 V 动作。需量启动、发射阶跃与故障瞬态；超过 14 V 时必须调整。此处采用断开型，非 13.8 V 钳位型。 |
| 电台插头与线束 | 优先 Yaesu E-DC-6 原厂线尾或经实测兼容的插头；确认正负极 | 手册未给出机械尺寸。成品在 3 A 时必须量电台插头电压。 |

二级失效保护建议在降压器使能端增加独立的约 18 V 输入欠压锁定，防止高边 PMOS 故障时 5 V/15 V 进入输出级。分压与迟滞需要按最终器件数据表计算，不能只照搬固定电阻值。

## 4. 输出线损与布局

从 12.5 V 降压器输出到电台插头，在 3 A 时仍要保持至少 12.0 V，则电子断路器、线材、连接器及焊点的总串联电阻应小于 `(12.5−12.0)/3 = 0.167 Ω`。设计留余量，初稿按总电阻不超过 0.12 Ω 选线；若采用 E-DC-6 长线，实测不合格时缩短线束或换低电阻线束。

降压芯片与电感的开关电流环路应最小，采用连续地平面，输入/输出滤波靠近功率级布置。由于 FT2D 可接收 VHF/UHF，必须在 144 MHz、430 MHz 和常用接收频点比较底噪；元件声称“低 EMI”不能代替整机测试。手册特别提醒，外接电源供电发射时使用机载天线可能让射频干扰电源，宜使用外接天线并将电源与机身分开。

## 5. 样机验收顺序

1. 不接电台，烧录并读回 STUSB4500 NVM；断电重启后再次读取确认。
2. 用 5 V、15 V / 3 A、20 V / 2.25 A、20 V / 3 A 电源分别测试。前三种情况下电台端不得出现持续供电，20 V / 3 A 时应正常启动。
3. 接电子负载，在 0、0.5、1、2、3 A 稳态和 0↔3 A 阶跃下测电台插头电压、纹波、板温与效率；电台插头应持续位于 12–14 V。
4. 不接电台，测试输出短路、过流和降压器异常升压的故障注入；示波器核对保护动作及输出峰值，超过电台耐受范围不得接入实机。
5. 确认插头机械匹配和极性，再用 FT2D 做关机充电、接收、低功率及 5 W 发射测试；记录插头电压、温升与 144/430 MHz 底噪变化。

## 6. 一手资料

- [Yaesu FT2DR/DE 操作手册](https://yaesu.com/Files/DFDF4D53-1B78-7375-E6C7A6E4B192BE13/FT2DR_DE_EH060M203_1608Y-EM-1.pdf)
- [STUSB4500 数据表](https://www.st.com/resource/en/datasheet/stusb4500.pdf)
- [STUSB4500 NVM 配置工具快速指南](https://www.st.com/resource/en/product_presentation/stswstusb002_quick_start_v3_2.pdf)
- [TI LM61460-Q1 产品与数据表](https://www.ti.com/product/LM61460-Q1)
- [TI TPS25947 产品与数据表](https://www.ti.com/product/TPS25947)
- [USB-IF 线缆标识说明](https://usb.org/cable_connector)
