Accelerator6666/Yaesu-FT2D-USBC-charge/manufacturing/Rev_B/QUOTE_PREVIEW_ONLY_NOT_RELEASED/FT2D_RevB_JLC_BOM_QUOTE_ONLY_NOT_APPROVED.csv

Comment | Designator | Footprint | JLCPCB Part #
C1608X7R1A105K080AC | C1 | Capacitor_SMD:C_0603_1608Metric | C5332007
C1608X7R1A105K080AC | C2 | Capacitor_SMD:C_0603_1608Metric | C5332007
CL21B105KAFNFNE | C3 | Capacitor_SMD:C_0805_2012Metric | C1712
C1608X7R1H473KT000N | C4 | Capacitor_SMD:C_0603_1608Metric | C380378
CL21B105KAFNFNE | C5 | Capacitor_SMD:C_0805_2012Metric | C1712
CGA3E1X7R1C105K080AC | C10 | Capacitor_SMD:C_0603_1608Metric | C194115
C1608X7R1H104K080AE | C12 | Capacitor_SMD:C_0603_1608Metric | C2167477
C1608X7R1H104K080AE | C13 | Capacitor_SMD:C_0603_1608Metric | C2167477
GRM32ER71H106KA12L | C14 | Capacitor_SMD:C_1210_3225Metric | C77102
GRM32ER71H106KA12L | C15 | Capacitor_SMD:C_1210_3225Metric | C77102
GRM32ER71H106KA12L | C16 | Capacitor_SMD:C_1210_3225Metric | C77102
GRM32ER71H106KA12L | C17 | Capacitor_SMD:C_1210_3225Metric | C77102
EEHZA1V470P | C18 | Capacitor_SMD:CP_Elec_6.3x5.8 | C178639
GCM188R71E104KA57D | C19 | Capacitor_SMD:C_0603_1608Metric | C85861
1210X476M250CT | C20 | Capacitor_SMD:C_1210_3225Metric | C3848311
1210X476M250CT | C21 | Capacitor_SMD:C_1210_3225Metric | C3848311
1210X476M250CT | C22 | Capacitor_SMD:C_1210_3225Metric | C3848311
MA25V220M6X8 | C23 | Capacitor_SMD:CP_Elec_6.3x7.7 | C46550464
GCM188R71E104KA57D | C24 | Capacitor_SMD:C_0603_1608Metric | C85861
1210X476M250CT | C25 | Capacitor_SMD:C_1210_3225Metric | C3848311
GRM188Z71E225KE43D | C26 | Capacitor_SMD:C_0603_1608Metric | C415535
GRM1885C1H332JA01D | C27 | Capacitor_SMD:C_0603_1608Metric | C77036
GRM1885C1H222JA01D | C28 | Capacitor_SMD:C_0603_1608Metric | C77033
ESDA25P35-1U1M | D1 | FT2D:ST_ESDA25P35_1U1M | C1974707
ESDA25W | D2 | Package_TO_SOT_SMD:SOT-323_SC-70 | C2935152
0468003.NRHF | F1 | Fuse:Fuse_1206_3216Metric | C41342
TYPE-C-31-M-12 | J1 | Connector_USB:USB_C_Receptacle_HRO_TYPE-C-31-M-12 | C165948
SRG1260-100-M | L1 | FT2D:JIERR_SRG1260_100M | C53463013
STL6P3LLH6 | Q1 | FT2D:ST_PowerFLAT_3p3_TypeF | C457492
RC0603FR-0710KL | R1 | Resistor_SMD:R_0603_1608Metric | C98220
RC0603FR-074K7L | R2 | Resistor_SMD:R_0603_1608Metric | C99782
RC0603FR-074K7L | R3 | Resistor_SMD:R_0603_1608Metric | C99782
RC0603FR-071KL | R4 | Resistor_SMD:R_0603_1608Metric | C22548
RC0603FR-1322KP | R5 | Resistor_SMD:R_0603_1608Metric | C5717132
RC0603FR-07470RL | R6 | Resistor_SMD:R_0603_1608Metric | C114669
RC0603FR-07100KL | R7 | Resistor_SMD:R_0603_1608Metric | C14675
RT0603BRD07100KL | R12 | Resistor_SMD:R_0603_1608Metric | C122538
RT0603BRD078K66L | R13 | Resistor_SMD:R_0603_1608Metric | C861591
RC0603FR-07100KL | R15 | Resistor_SMD:R_0603_1608Metric | C14675
AC0603FR-0733K2L | R16 | Resistor_SMD:R_0603_1608Metric | C227824
RMCF0603FT133K | R17 | Resistor_SMD:R_0603_1608Metric | C2484234
RC0603FR-0710KL | R18 | Resistor_SMD:R_0603_1608Metric | C98220
RC0603JR-070RL | R19 | Resistor_SMD:R_0603_1608Metric | C95177
RTT034703FTP | R20 | Resistor_SMD:R_0603_1608Metric | C103658
RC0603FR-07100KL | R21 | Resistor_SMD:R_0603_1608Metric | C14675
RT0603BRD07102KL | R22 | Resistor_SMD:R_0603_1608Metric | C861068
RC0603FR-0710KL | R23 | Resistor_SMD:R_0603_1608Metric | C98220
RC0603FR-07100KL | R24 | Resistor_SMD:R_0603_1608Metric | C14675
RC0603FR-0712KL | R25 | Resistor_SMD:R_0603_1608Metric | C114659
0603WAF8200T5E | R26 | Resistor_SMD:R_0603_1608Metric | C23253
STUSB4500QTR | U1 | Package_DFN_QFN:QFN-24-1EP_4x4mm_P0.5mm_EP2.7x2.7mm | C2678061
LM61460AASQRJRRQ1 | U2 | FT2D:TI_RJR0014A | C1855832
TPS259474ARPWR | U3 | FT2D:TI_RPW0010A | C3662807
