Accelerator6666/Yaesu-FT2D-USBC-charge/manufacturing/Rev_B/REVIEW_ONLY_NOT_FOR_FAB/FT2D_RevB_SMT_sourcing_DRAFT_preview.png

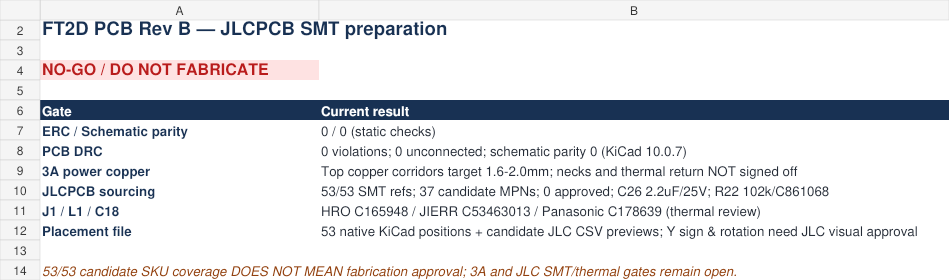
manufacturing/Rev_B/REVIEW_ONLY_NOT_FOR_FAB/FT2D_RevB_SMT_sourcing_DRAFT_preview.png
