Accelerator6666/Yaesu-FT2D-USBC-charge/manufacturing/Rev_B/REVIEW_ONLY_NOT_FOR_FAB/RevB_In2_power_stitch_REVIEW_ONLY.png

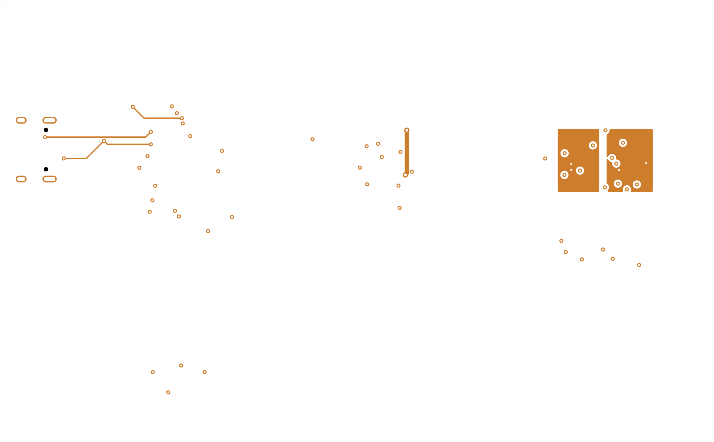
manufacturing/Rev_B/REVIEW_ONLY_NOT_FOR_FAB/RevB_In2_power_stitch_REVIEW_ONLY.png
