Accelerator6666/Yaesu-FT2D-USBC-charge/manufacturing/Rev_B/REVIEW_ONLY_NOT_FOR_FAB/RevB_top_copper_REVIEW_ONLY.png

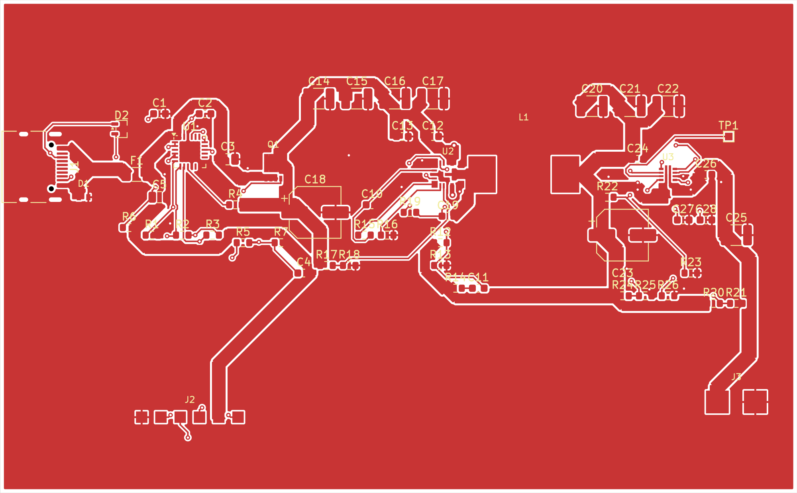
manufacturing/Rev_B/REVIEW_ONLY_NOT_FOR_FAB/RevB_top_copper_REVIEW_ONLY.png
