Accelerator6666/Yaesu-FT2D-USBC-charge/prototypes/Rev_P_Perfboard/TEST_PLAN_12V_DIRECT.md

# FT2D Rev P-D：TA3005U 12 V PD 直通版验收清单

> **未实测，NO-GO，不得直接接 FT2D。** 这是省掉 Buck 的优先低成本实验路线，不是量产/设备安全认证。必须记录日期、实测值与照片/波形。使用[本版接线图](wiring_12v_direct.svg)；不能与[20 V 降压版测试](TEST_PLAN.md)混用。

## 已知输入条件

用户上传的 **TA3005U 商品参数截图**：

| 接口 | 截图公布的单口档位 | 本次选择 |
|---|---|---|
| USB-C **C1** | `12 V / 3 A`、`20 V / 5 A`、`28 V / 5 A`（另有其他档） | **首选：只用 C1 的 12 V / 3 A** |
| USB-C **C2** | `12 V / 3 A`、`20 V / 5 A`、`28 V / 5 A`（另有其他档） | 可替代 C1，单独测试 |
| USB-C **C3** | `12 V / 2.5 A`、`15 V / 2 A`，44 W 上限 | **不能满足 12 V / 3 A 目标** |
| USB-A | `12 V / 1.5 A` 等 | 不用 |

**先验证实物。** 商品页截图不等于已测得手中电源的输出；核对底部铭牌型号、实际接口丝印和输出 PDO。使用单口测试，其他端口暂不插设备，以免功率重新分配。140 W / 300 W 的宣传数字不能代替 12 V / 3 A PDO 实测。

## 目标接法

`TA3005U C1/C2 → USB-C 3A+ 线 → Adafruit #5807 V+ → PN Labs Protect IN+ → Protect OUT+ → F2 (Littelfuse 0287004.L, 4A ATO) → 电子负载，最后才接 E-DC-6/FT2D`

所有负极：`#5807 GND → Protect IN−`；`Protect OUT− → 电子负载/FT2D 负极`。采用 **18 AWG 独立绝缘导线**，洞洞板仅机械固定。不装降压模块，不装 20 V 输入保险丝 F1。

**Adafruit #5807（HUSB238）焊桥设置，必须断电操作**：

1. 识别正背面实际丝印；剪开默认 `5V` 焊桥，**仅短接 `12V`** 电压焊桥；`9V / 15V / 18V` 保持断开。
2. 剪开默认 `1A` 电流焊桥，`2A` 焊桥保持断开；按 Adafruit 原厂说明请求 **3A**。
3. 重新检测焊桥没有毛刺/邻近短路，先不接 OVP 或电台，万用表测 `V+` 对 `GND`（TP1）。**不得把默认 5 V / 1 A 设置误当 12 V。**
4. 原厂设置出处：[Adafruit #5807 HUSB238 Pinouts](https://learn.adafruit.com/adafruit-husb238-usb-type-c-power-delivery-breakout/pinouts)。如果采用 #5991 或其他触发板，只能遵守该板原厂的设置方法，不能照抄 #5807 焊桥。

## A：无电检查（强制）

| 编号 | 操作 | 放行标准 | 结果 |
|---|---|---|---|
| A01 | 读取实际 TA3005U 底部铭牌及 C1/C2 丝印 | 手中型号和截图一致，确认所选端口支持固定 12 V / ≥3 A | 待填 |
| A02 | 核对 #5807 焊桥、`V+ / GND`、Protect XT60 输入/输出极性 | 12 V 与 3 A 请求设置正确，不把 XT60 输入输出插反 | 待填 |
| A03 | 检查 F2、18 AWG 电线、绝缘、壳体固定 | 3 A 主电流不经过洞洞板薄铜环；无短路/裸露触点，电缆有应力消除 | 待填 |
| A04 | 万用表通断档测 E-DC-6 插头**真实触点** | 对应的正负线与八重洲手册一致，**不凭中心针或外壳猜极性** | 待填 |

## B：PD 输出验证（**只接触发板**，强制）

| 编号 | 操作 | 放行标准 | 结果 |
|---|---|---|---|
| B01 | 仅从 C1 插入额定 ≥3 A USB-C 线至 #5807，量 TP1 | 请求并实测约 12 V，实际极性正确；若输出 5 / 9 / 15 / 20 / 28 V，**立即断电并停止** | 待填 |
| B02 | 换到 C2 单独复测；再将选定 C1/C2 记录固定 | 12 V 档稳定，记录最终选定端口 | 待填 |
| B03 | 接限流电子负载，从 0.5 A 到 1 A、2 A、3 A，每档观察 5 分钟 | TP1 在正常电压范围、PD 不反复重新协商、触发板/USB 端子不明显过热 | 待填 |
| B04 | 冷启动、拔插、0↔3 A 阶跃 | 用示波器记录 TP1 峰值/跌落；额定 3 A 时不得因为没有电流余量而反复限流、断电或重启 | 待填 |

**电源档位恰好是 12 V / 3 A，不能预设它一定能在 FT2D 发射负载的短时跃变下保持足够电压。** 若出现重启或 3 A 压降过大，停止 P-D，转回 `20 V → 12 V Buck` 的 [P-B 备选路线](README.md)。

## C：安装 OVP 后的 12 V / 3 A 性能（强制；仍只接电子负载）

| 编号 | 操作 | 放行标准 | 结果 |
|---|---|---|---|
| C01 | `#5807 → OVP → F2 → 电子负载`，0.5 / 1 / 2 / 3 A | TP3 电压 11.5–12.5 V（工程筛选目标），无误关断；测 `TP1−TP3` 正极压降 | 待填 |
| C02 | 3 A 连续 **30 分钟** | 供电稳定，记录 USB-C 插头、触发板、OVP、F2、线束温度；工程目标外露件低于 70°C、线接点低于 50°C，仍须遵守各元件规格 | 待填 |
| C03 | 在 0↔3 A 间切换并重复上电 | TP3 不出现危险高压尖峰；记录最低电压、波形、是否发生 PD 重新协商；示波器无法测量时不能签核 | 待填 |
| C04 | 3 A 输出纹波/尖峰及射频前置检查 | 记录 mVpp 与频谱；建议先以 <100 mVpp 为内部筛选目标，**最终以电台接收噪声验证为准** | 待填 |
| C05 | 复核过流/短路保护响应 | 用受控电子负载/限流工具测试，不直接拿裸线短接；确认不会有热损伤；**4 A 延时保险丝不保证先于 PD 限流动作** | 待填 |

## D：独立高边 OVP 故障注入（强制；绝无 FT2D）

1. **关闭并断开充电器、#5807 和电台尾线。** 单独给 `Protect.IN+ / IN−` 接可调、限流的台式直流电源，输出接电子负载＋示波器。XT60 极性按厂家丝印确认。
2. PN Labs Protect 官方公式 `R_OVC(kΩ)=(V_CUTOFF−1.95)/2.89`。预调 **14.3 V 截断（约 4.27 kΩ）**，必须**断电**时测电位器阻值。[厂家原文](https://pnlabs.ca/shop/protect-5-30v-dc-power-protection-module)。
3. 测 12.0 / 13.5 / 14.0 / 14.3 / 14.8 / 16 V，找到**实际**关断点；再用受限电流的台式电源模拟误接 20 V，必要时按器件额定与仪器能力检查 28 V 异常输入。**不要用 PD 充电器来制造故障。**

| 编号 | 操作 | 放行标准 | 结果 |
|---|---|---|---|
| D01 | 12 V 输入下，OVP 正常导通 | 低压降，不误断，输出极性正确 | 待填 |
| D02 | 缓慢提高输入验证切断与恢复 | **实际过压关断 14.0–14.8 V**，自动恢复有合理迟滞；输出端示波器测得任何波峰必须 **<16 V** | 待填 |
| D03 | 输入 17–20 V 故障，受限电流 | OVP 保持输出隔离，不重复向输出侧发送高压脉冲，不异常发热 | 待填 |
| D04 | 根据设备/仪器额定进行 28 V 故障模拟 | 用户充电器有 28 V PDO；确认保护板对该异常也维持断开、不损坏或过热；不能安全执行则保持 NO-GO，另行工程评估 | 待填 |
| D05 | 恢复真实 #5807 12 V PD 输入，重复 3 A / 30 min 与上电 | 完整链路 TP3 稳定、没有开机尖峰和瞬态关断 | 待填 |

**STOP：** 没有独立可调限流电源、示波器、实际 OVP 关断结果，或 3 A 动态下掉压重启，**不连接 FT2D**。TVS 二极管单独并在输出端不能替代这种断电保护。

## E：只有 A–D 全部通过，才开始 FT2D 联机评估

| 编号 | 操作 | 放行标准 | 结果 |
|---|---|---|---|
| E01 | 最后检查 E-DC-6 真实接点极性、TP3 输出 | 电台端 11.5–12.5 V，插头无反极性/短路 | 待填 |
| E02 | 仅接收，观察 144/430 MHz 频段 | 正常工作，记录相对电池供电噪声/S 表变化与是否重启 | 待填 |
| E03 | 在法律允许且有合适天线/额定 RF 假负载时，低功率到短时高功率发射 | 无明显额外射频杂音、电压掉落、重启及过热 | 待填 |
| E04 | 在预计使用的绝缘盒中重复接收和必要的发射工作循环 | 固定牢靠，温升和 RF 干扰可接受；不长时间无人值守 | 待填 |

## 签核记录

| 关键结果 | 实测值/证据 |
|---|---|
| TA3005U 实物铭牌、选定 C1/C2 与 12 V PDO | 待填 |
| Adafruit #5807 设置及 TP1 带载电压 | 待填 |
| OVP 实际关断点、20 V / 28 V 故障输出波形 | 待填 |
| TP3 在 3 A 时电压、启动最低值及最高值 | 待填 |
| 3 A 30 min 温升与 USB-C 接头状态 | 待填 |
| E-DC-6 插头极性照片 | 待填 |
| 射频接收和发射测试结果 | 待填 |
| 测试者 / 日期 / 最终放行 | 待填 |

即使商品截图写有 12 V / 3 A，**完成电气保护与满载验证之前，本文件状态一直是 NO-GO**。
