Accelerator6666/Yaesu-FT2D-USBC-charge/prototypes/Rev_P_Perfboard/TEST_PLAN.md

# FT2D Rev P-B：20 V 降压备选版的台架验收与放行清单

> 本文件只适用于 **20 V PD 触发＋Buck 降压** 的 P-B 路线。对于 TA3005U C1/C2 的 **12 V 直通 P-D 路线**，请使用 [TEST_PLAN_12V_DIRECT.md](TEST_PLAN_12V_DIRECT.md)，切勿把两套接线/测试点电压混用。

**NO-GO：本表未填写实测结果前，不得接 FT2D。** 所有“通过”均须记录设备、实测值和日期；有疑问一律断电检查。**禁止用电台本体代替电子负载。**

## 测试台准备

- 具备 20 V / ≥3 A 固定档的 USB-C PD 电源和额定电缆；另备**有电流限制**的可调直流电源（专供 OVP 故障注入测试）。
- 电子负载 ≥12 V × 3 A＝**36 W 持续**、最好 ≥60 W，带散热；数字万用表；最好有示波器、电流表和热电偶/热像仪。
- 预留 TP1、TP2、TP3；红表笔接“+”测点，黑表笔接同段 GND。先做断电通断检查。
- 首台试验期间**不焊接或不插入电台尾线**，尽可能用实验接线端子连接电子负载。
- 保护模块选型、额定电压与引脚映射必须与所买的实物说明逐项对应；不允许按本文件推测未知模块脚序。

## A：不带电查线（强制）

| 编号 | 测试 | 通过标准 | 实测/签名 |
|---|---|---|---|
| A01 | USB-C 触发板 20 V+、GND，降压输入/输出端子，OVP 输入/输出，F1/F2 方向 | 与 [wiring.svg](wiring.svg) 一致，所有 GND 连接明确；**20 V 原始线不与 12 V 输出误连** | 待填 |
| A02 | 从输出插头实际触点测 E-DC-6 尾线和正负线通断 | 确认官方 E-DC-6 正/负线与实际插头正/负映射，**无短路**；禁止凭插头中心/外壳猜测 | 待填 |
| A03 | 18 AWG 主电源线、保险丝座、过线孔、绝缘柱、外壳 | 有绝缘和应力消除，DC 端不裸露，3 A 不经洞洞板细铜环 | 待填 |

## B：USB-C PD 输入（只连接 PDS1，强制）

| 编号 | 测试 | 通过标准 | 实测/签名 |
|---|---|---|---|
| B01 | 从兼容充电器连接 PD，万用表读 TP1 | **Adafruit #5807：先断开电源，剪开 5V 与 1A 默认焊桥，其他电压焊桥及 2A 焊桥保持断开**，复核无毛刺短路，再上电；PD 协商后 **约 20 V**；若只有 5/9/15 V，不继续后级测试 | 待填 |
| B02 | 更换不支持 20 V 的 USB-C 供电器（如果有） | **不得把不明电压误标为 20 V**；记录输出实际行为和上电时序；此时绝不接电台 | 待填 |
| B03 | 记录 PD 触发模块铭牌及图片 | 记录 #5807/#5991 或通用板的**真实丝印/焊桥/请求电流**；#5807 需自己安装接线端子，检查 3 A 级电流链的接点温升 | 待填 |

## C：降压性能（只接电子负载，强制）

先连接 PD→F1→BUCK，不接电台；如果是可调 XL4016 **空载调到 12.0 V 后锁住电位器**。

| 编号 | 负载 / 测试 | 通过标准 | 实测/签名 |
|---|---|---|---|
| C01 | 0 A 和 0.5 A，读 TP2 | 11.5–12.5 V，启动无明显异常；测量输出极性正确 | 待填 |
| C02 | 1 A、2 A、3 A 各保持至少 5 min | 每档 TP2 11.5–12.5 V，连接器无接触不良、未反复重启 | 待填 |
| C03 | 3 A **连续 30 min**（36 W） | 稳压通过，无热关断；记录模块芯片/电感/散热片/端子温度（工程目标外露部位 <70 °C，绝缘线接头 <50 °C；不代替各器件原厂温度限值） | 待填 |
| C04 | 0↔3 A 负载阶跃、拔插 PD | 示波器观察 TP2：无危险高压启动尖峰，暂定瞬态目标 <14.0 V；恢复时间和峰值留图；仅用万用表**无法证明**没有短时过冲 | 待填 |
| C05 | 3 A 纹波测量（示波器短接地弹簧/合理带宽限制） | 记录 mVpp；暂定 <100 mVpp 为进入射频测试的内部筛选目标，**实际电台干扰试验才是最终验收** | 待填 |
| C06 | 3 A 时输入 TP1、电流和效率 | 20 V × 输入电流不超过 PD 源供电能力；损耗与温升可接受。输出 36 W，85% 效率时理论输入约 42.4 W / 2.12 A，仅作参考 | 待填 |

## D：独立 OVP 过压关断（强制，**无电台**）

1. 完全断开 PD / 降压模块，**单独**用限流台式直流电源接入 `OVP.IN+ / IN−`；电子负载/示波器接 `OVP.OUT`，输出 F2 到电台的尾线**仍然不连接**。
2. 断电预调 PN Labs Protect 的 `OVC Res≈4.27 kΩ`（目标 14.3 V），以厂家实际调节方法为准；备用型号用其官方手册，不套本公式。
3. 从 12.0 V 缓慢升至 13.5 V、14.0 V、14.3 V、14.8 V、16.0 V，再降回 12.0 V；记录关断点、恢复点与输出波形。

| 编号 | 测试 | 通过标准 | 实测/签名 |
|---|---|---|---|
| D01 | 12.0 V 正常输入，输出/指示灯 | OVP 正常导通；TP3 极性正确，压降低；检查不误断 | 待填 |
| D02 | 逐步加压找到实际过压关断点 | **14.0–14.8 V** 实测关断；任何情况下不允许电台端输出达到 ≥16 V；必须示波器测量尖峰 | 待填 |
| D03 | OVP 输入维持 17–20 V 的受限电流故障状态 | OVP 一直隔离输出，不向 TP3 重复送高压脉冲；没有异常发热，符合模块额定保护范围 | 待填 |
| D04 | 从高压慢慢降低恢复 | 恢复动作符合厂家迟滞要求；多次重启无异常高压尖峰 | 待填 |
| D05 | 接好实际 BUCK→OVP→F2→电子负载，再重复 C02–C04 | 3 A 下 OVP 不误断，TP3 11.5–12.5 V，F2/线束温度合格，连接器无压降过大 | 待填 |

**STOP 条件：** 不能测到实际 OVP 截断、没有示波器或无法确认瞬态关断行为，则只能继续无电台的负载试验。常见 TVS“15 V 型号”并不意味着输出钳位在 15 V，不能替代 OVP。

## E：电台与射频（在 A–D 完全通过后）

| 编号 | 测试 | 通过标准 | 实测/签名 |
|---|---|---|---|
| E01 | 插头接入前最后一次测 TP3、E-DC-6 极性 | 稳定 **11.5–12.5 V**，极性与实际插头一致，关断保护已复核 | 待填 |
| E02 | 先仅接 FT2D **接收状态** | 正常启动，无重启或电源异常；在 144/430 MHz 典型频点比较电池与模块供电的接收噪声/S 表 | 待填 |
| E03 | 再做低功率发射、然后短时高功率发射；**仅在依法允许的条件下，并接好合适天线或额定 RF 假负载，禁止无负载发射** | 没有明显频率相关电源噪声、输出跌落、发热或重启；记录频点、电流和外壳温度 | 待填 |
| E04 | 装入预计使用的绝缘外壳，再做额定工作循环 | 外壳状态下接线无摩擦、散热充足、RF 干扰可接受；如需磁环/滤波须记录并重测 | 待填 |

## 验收记录

| 项目 | 值 |
|---|---|
| PD 充电器完整型号和 20 V PDO | 待填 |
| PD 触发成品板 SKU / 正背面照片 | 待填 |
| BUCK 具体型号与 VIN/VOUT 丝印 | 待填 |
| OVP 具体型号和设定实测关断点 | 待填 |
| USB-C 线与 E-DC-6 插头型号/极性照片 | 待填 |
| 3 A 连续 30 min 最高温度 | 待填 |
| 3 A 实测纹波 / 最大启动过冲 | 待填 |
| 144/430 MHz 接收噪声与输出变化 | 待填 |
| 测试人、日期与签核 | 待填 |

只有全部 `A/B/C/D` **通过**，且输出线束确认极性后，才能开始 `E`。通过 PCB DRC 或“模块商家标称 8 A”不能替代以上测量。
