Accelerator6666/Yaesu-FT2D-USBC-charge/FT2D_PD20V_12V5_3A_评审原理图.pdf

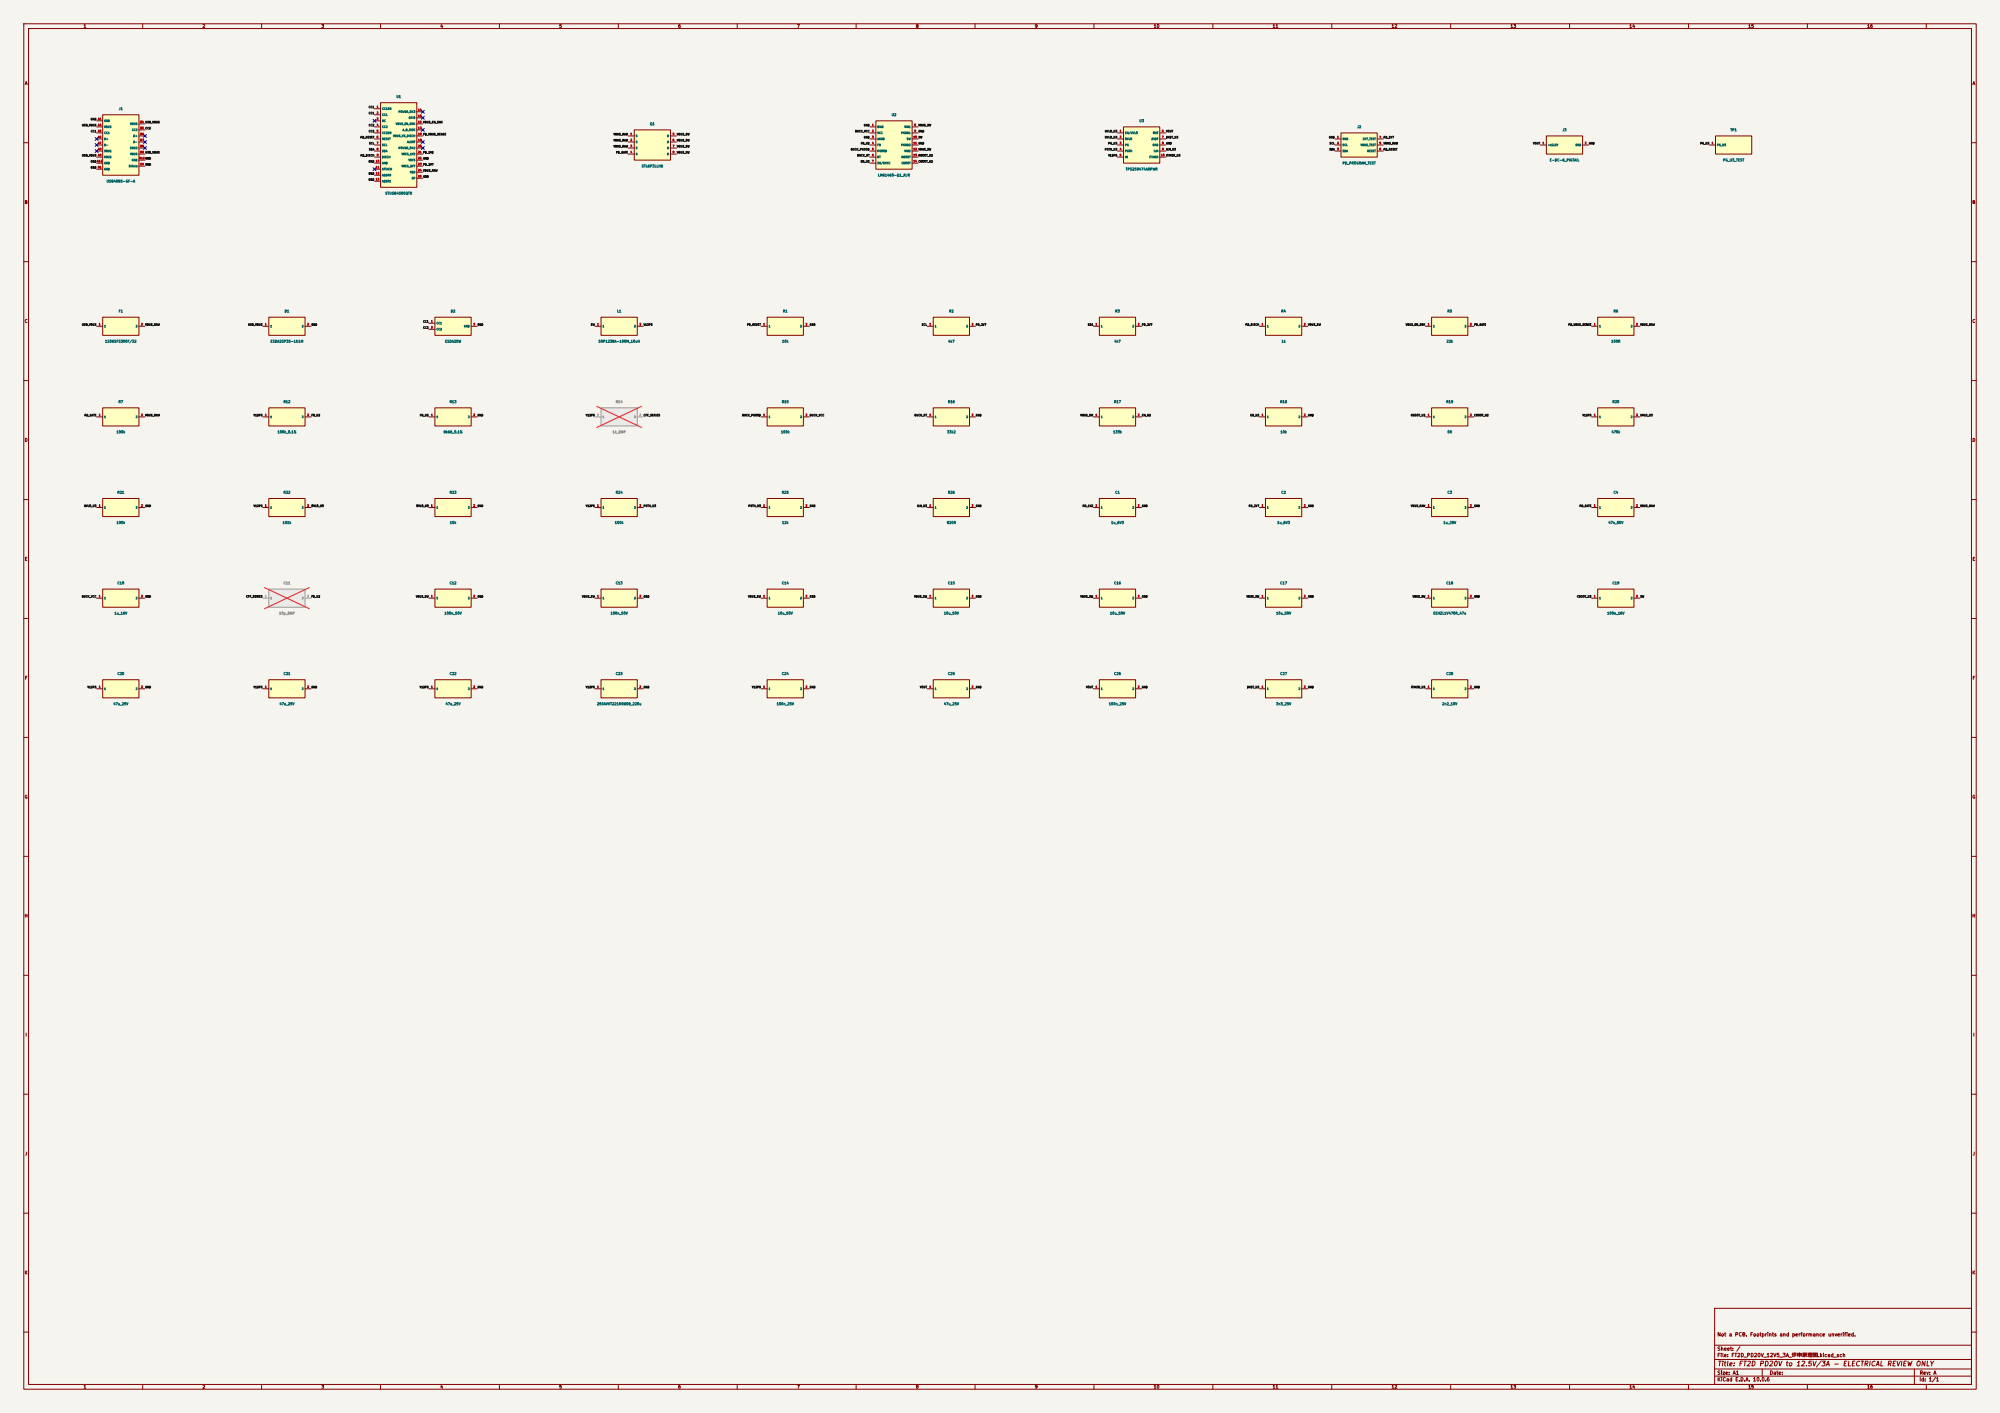
[picture p4: page 1]

Not a PCB. Footprints and performance unverified.

Sheet: /
File: FT2D_PD20V_12V5_3A_评审原理图.kicad_sch
Title: FT2D PD20V to 12.5V/3A - ELECTRICAL REVIEW ONLY

Size: A1 | Rev: A
KiCad E.D.A. 10.0.6 | Id: 1/1
