Accelerator6666/Yaesu-FT2D-USBC-charge/hardware/Rev_B/FT2D_PD20V_12V5_3A_评审原理图.kicad_pcb

## KiCad design hardware/Rev_B/FT2D_PD20V_12V5_3A_评审原理图.kicad_pcb (2026-10-26)

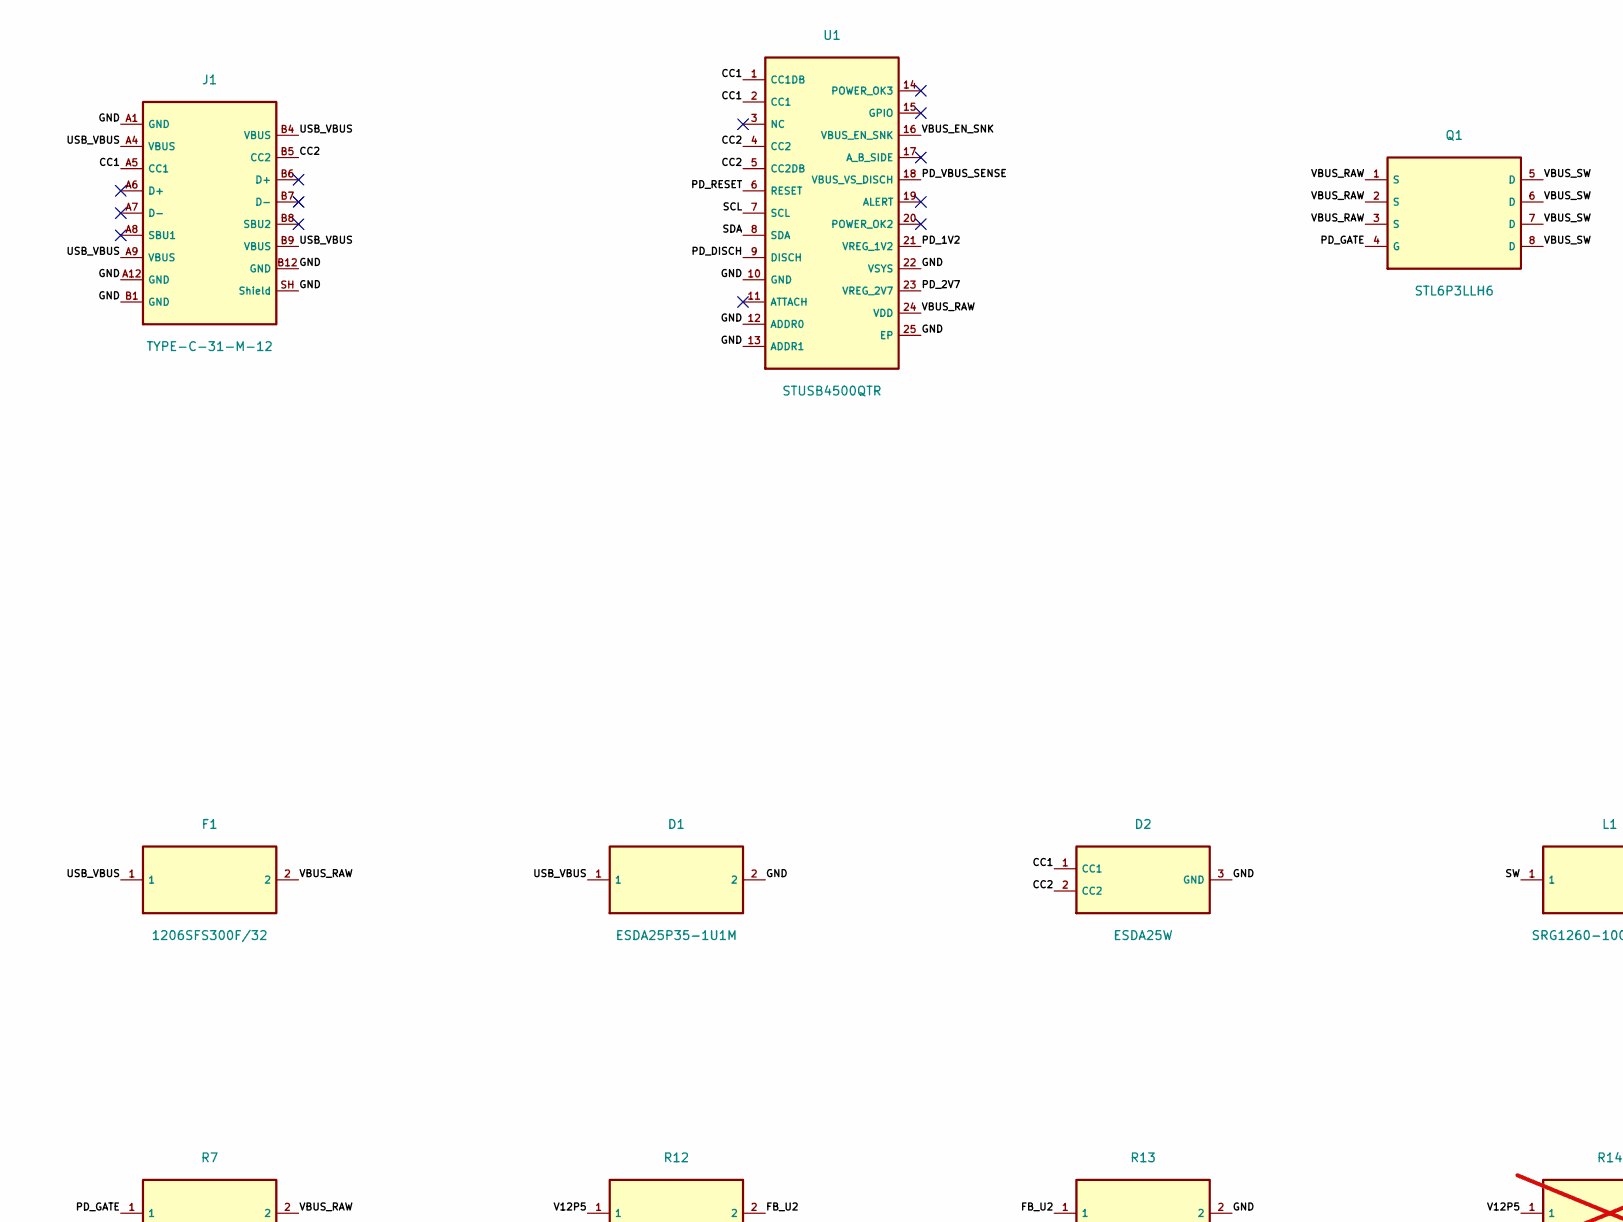
[picture p5: schematic FT2D_PD20V_12V5_3A_评审原理图.kicad_sch, FT2D PD20V to 12.5V/3A - ELECTRICAL REVIEW ONLY, part in row 1, column 1]

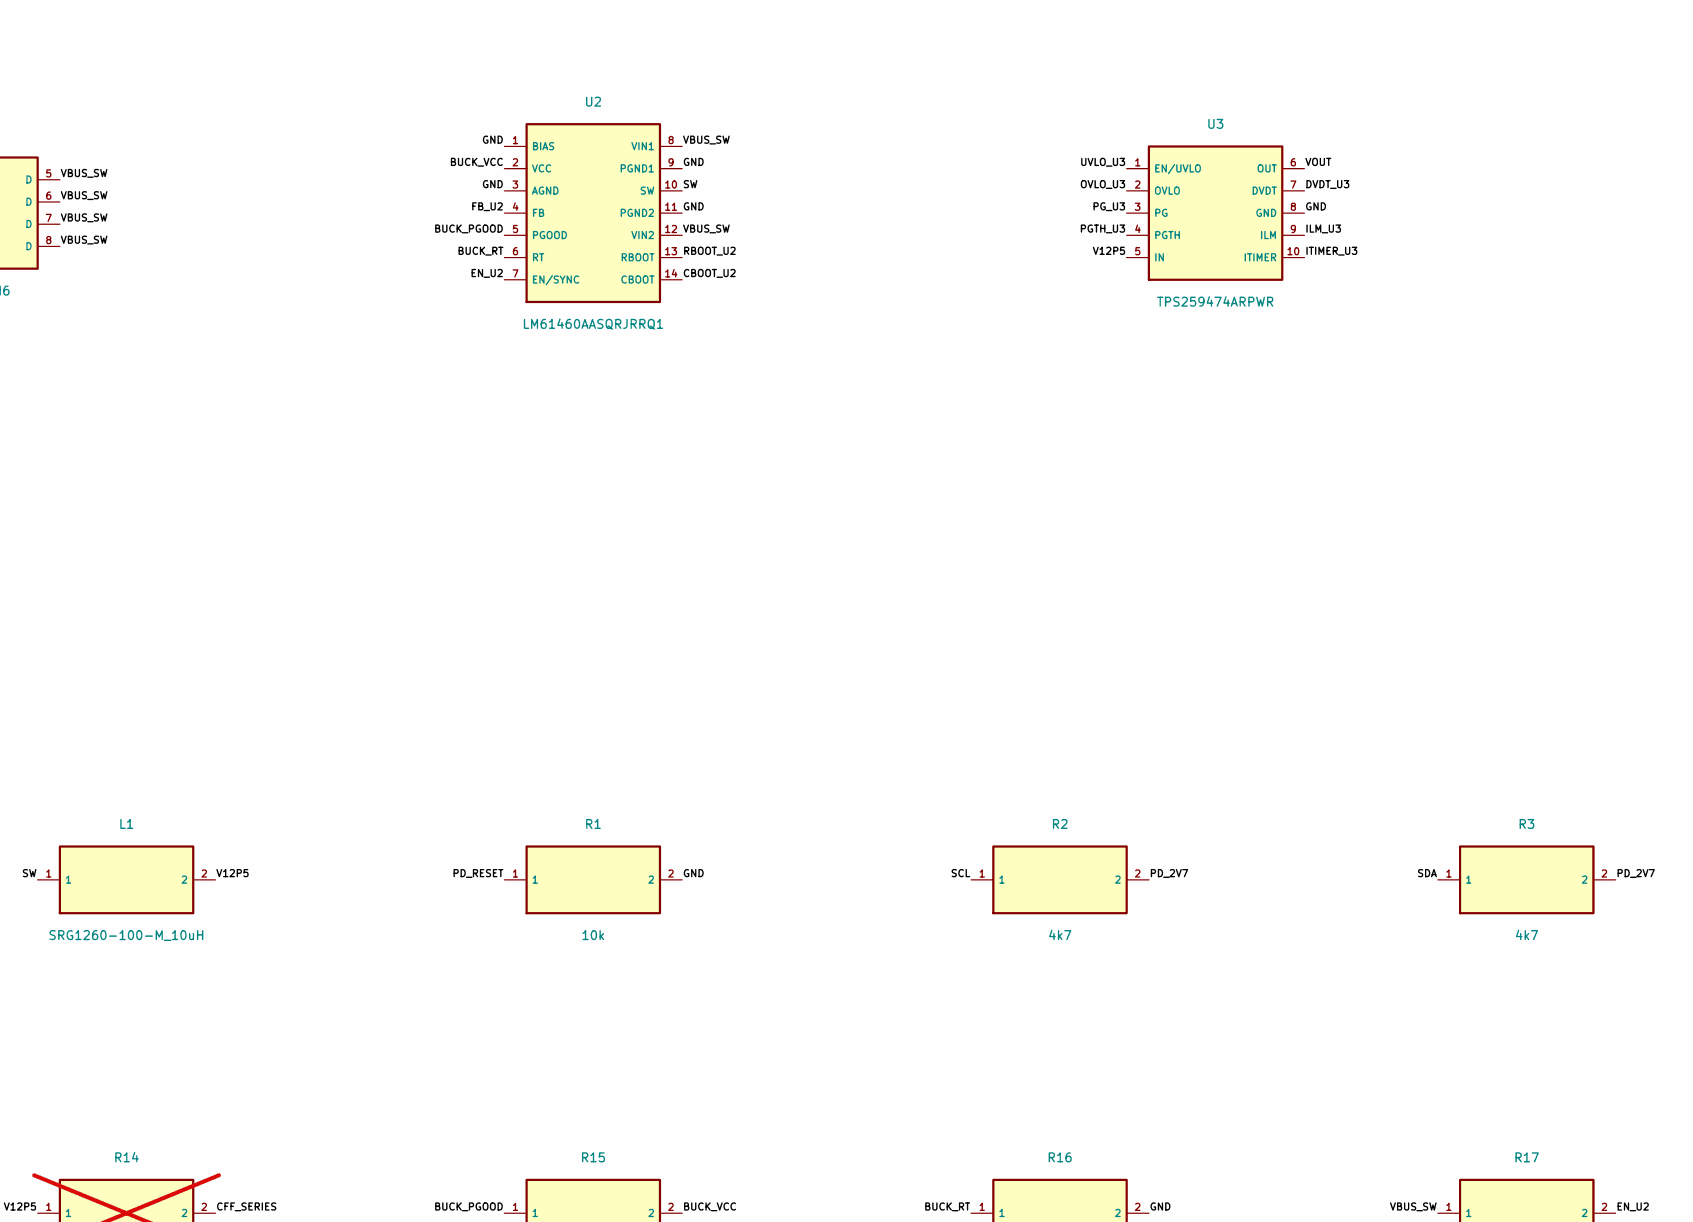
[picture p6: schematic FT2D_PD20V_12V5_3A_评审原理图.kicad_sch, FT2D PD20V to 12.5V/3A - ELECTRICAL REVIEW ONLY, part in row 1, column 2]

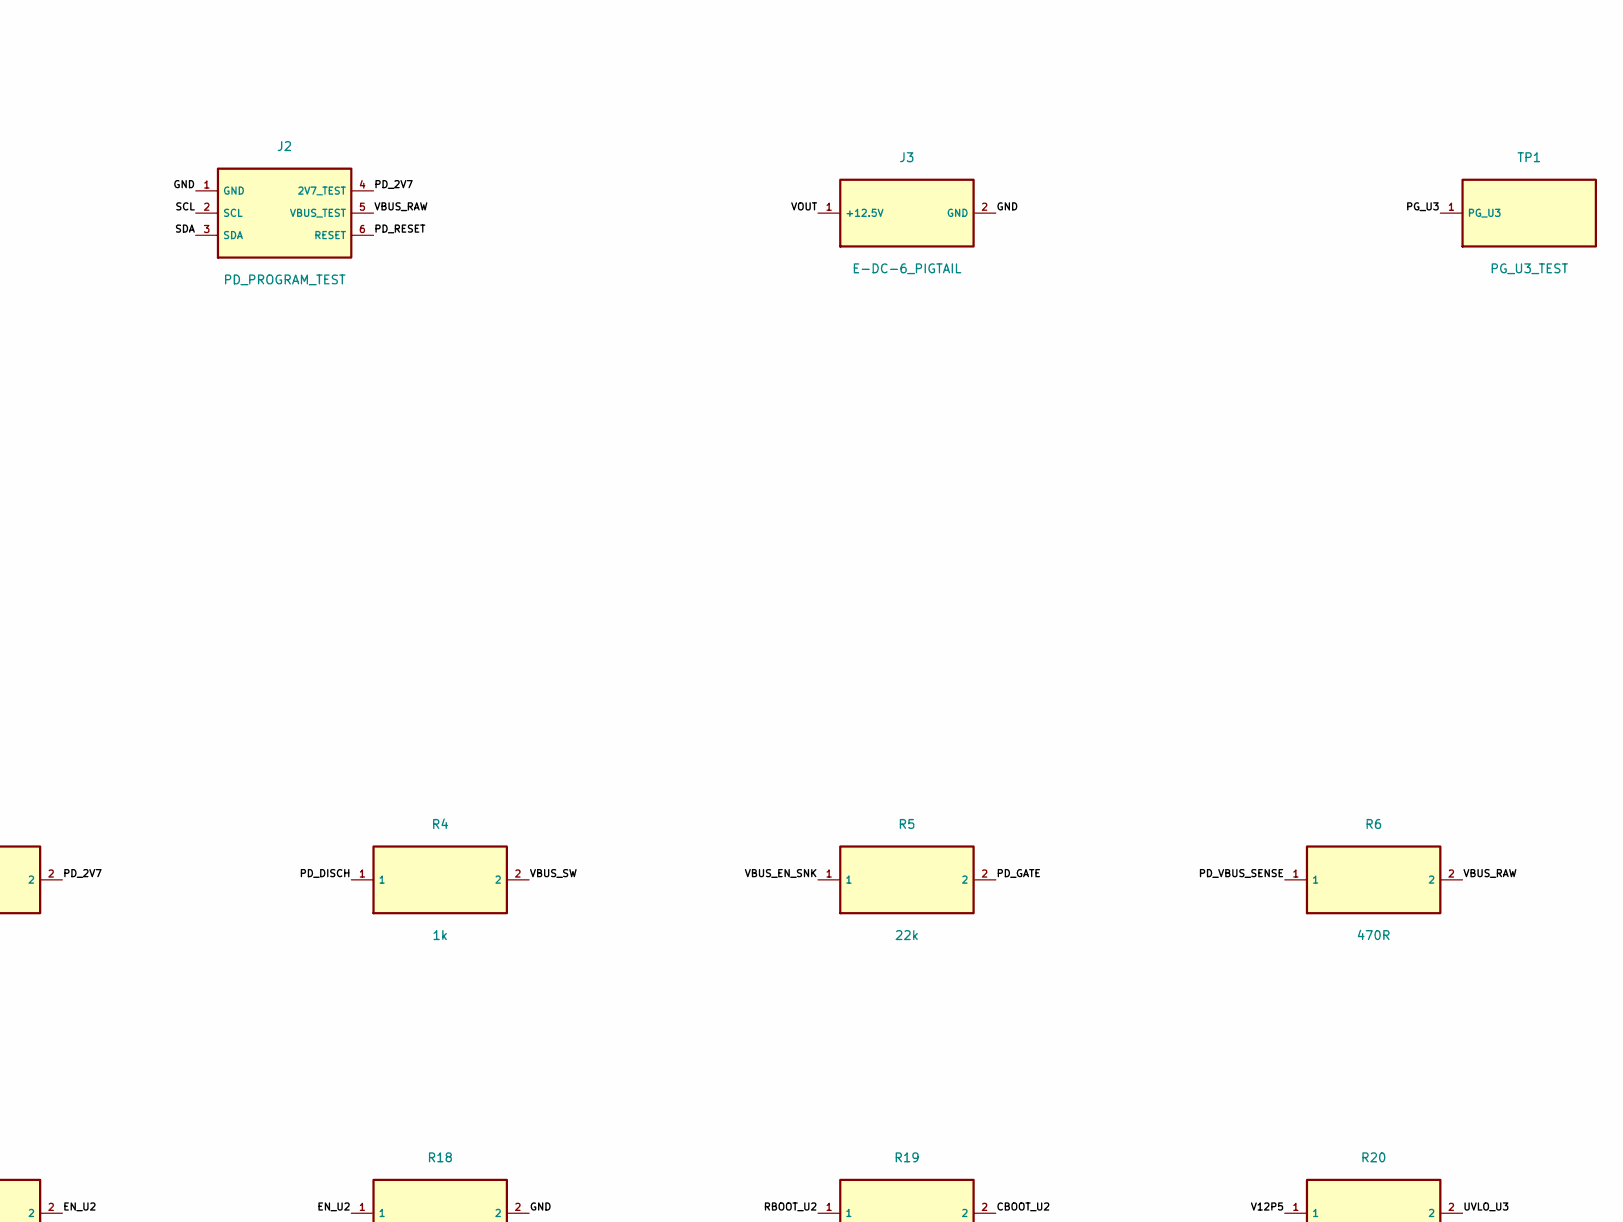
[picture p7: schematic FT2D_PD20V_12V5_3A_评审原理图.kicad_sch, FT2D PD20V to 12.5V/3A - ELECTRICAL REVIEW ONLY, part in row 1, column 3]

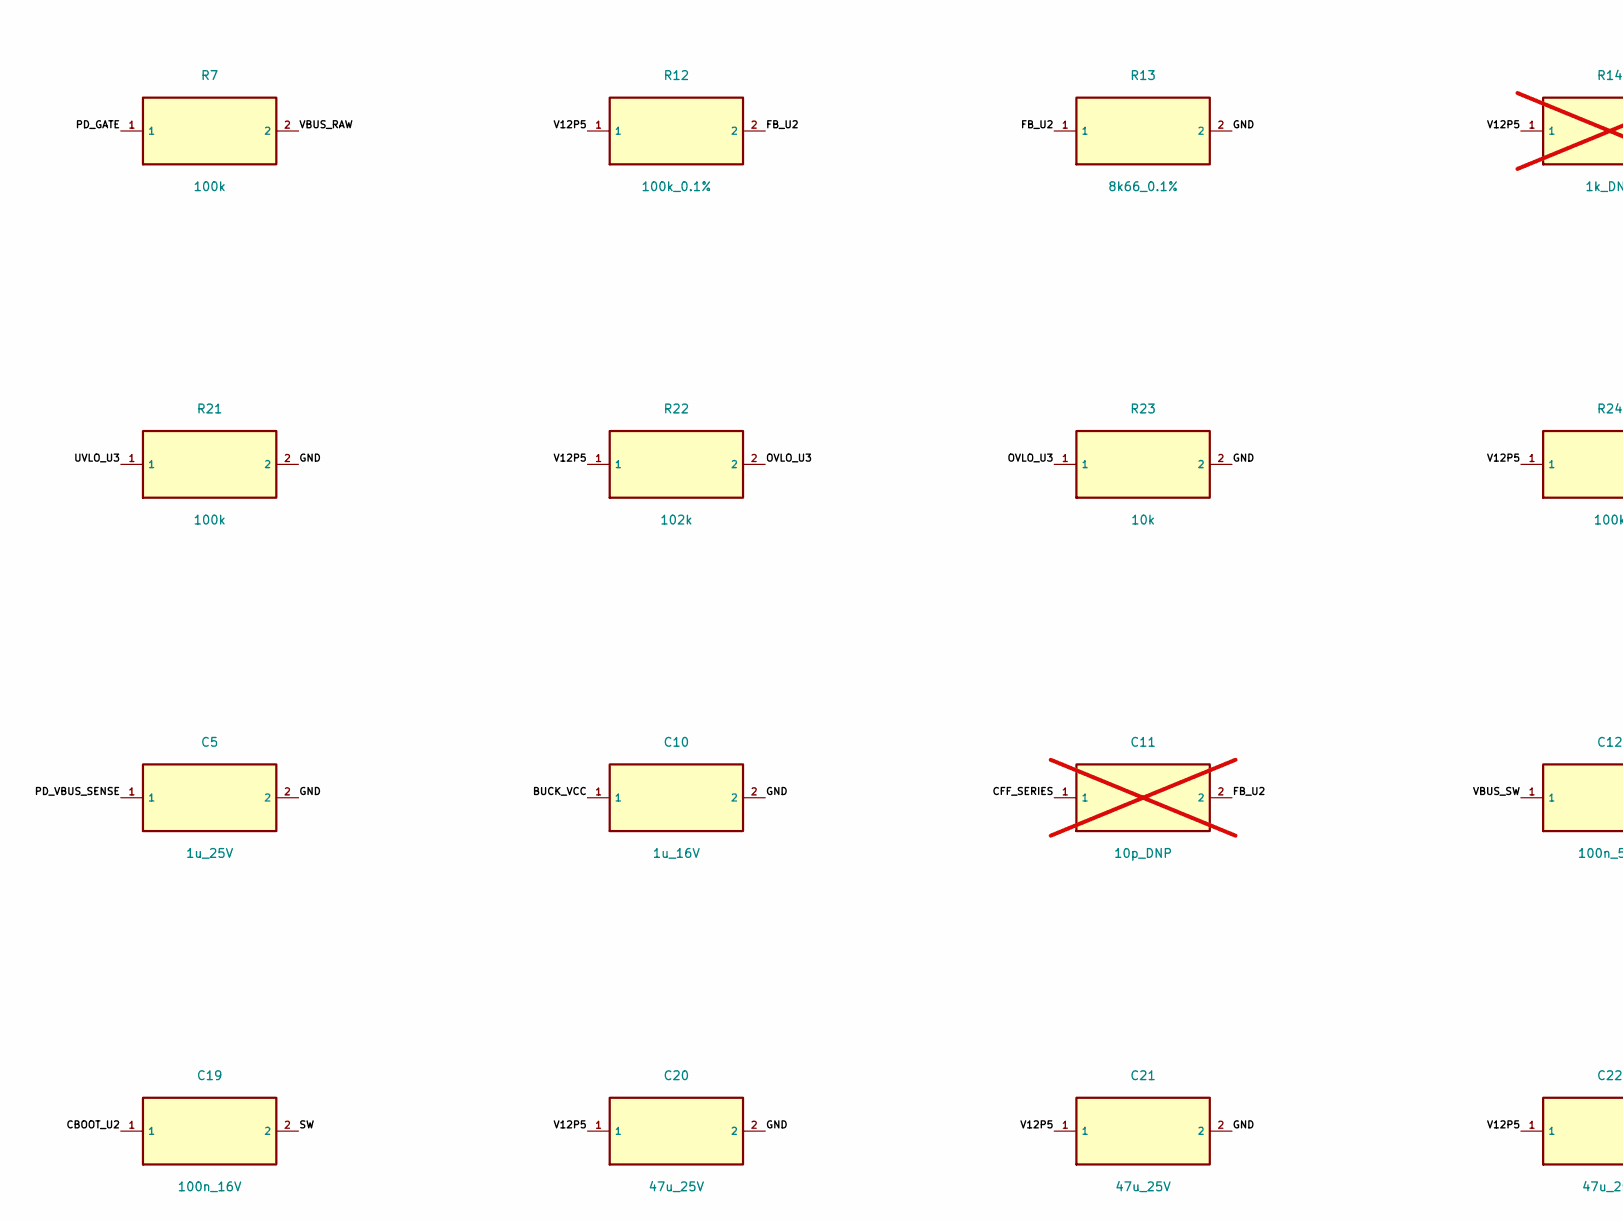
[picture p8: schematic FT2D_PD20V_12V5_3A_评审原理图.kicad_sch, FT2D PD20V to 12.5V/3A - ELECTRICAL REVIEW ONLY, part in row 2, column 1]

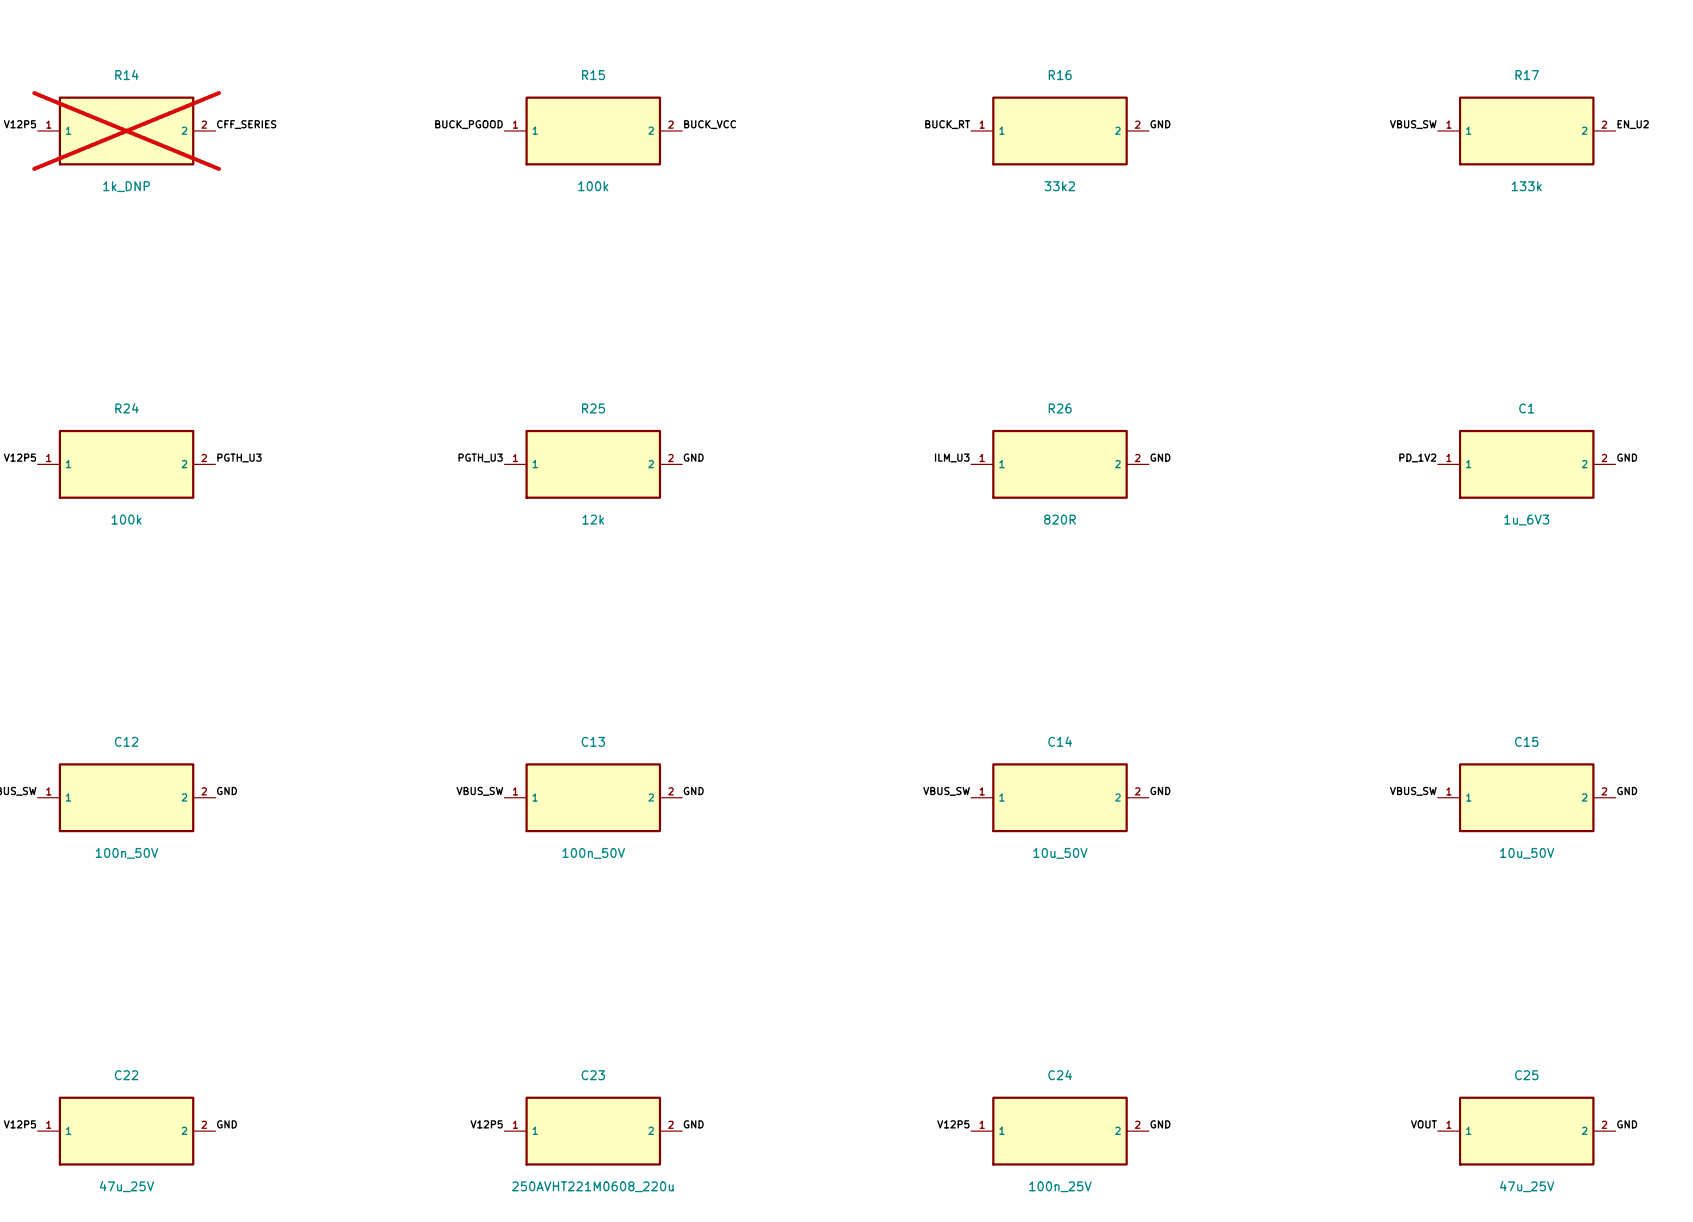
[picture p9: schematic FT2D_PD20V_12V5_3A_评审原理图.kicad_sch, FT2D PD20V to 12.5V/3A - ELECTRICAL REVIEW ONLY, part in row 2, column 2]

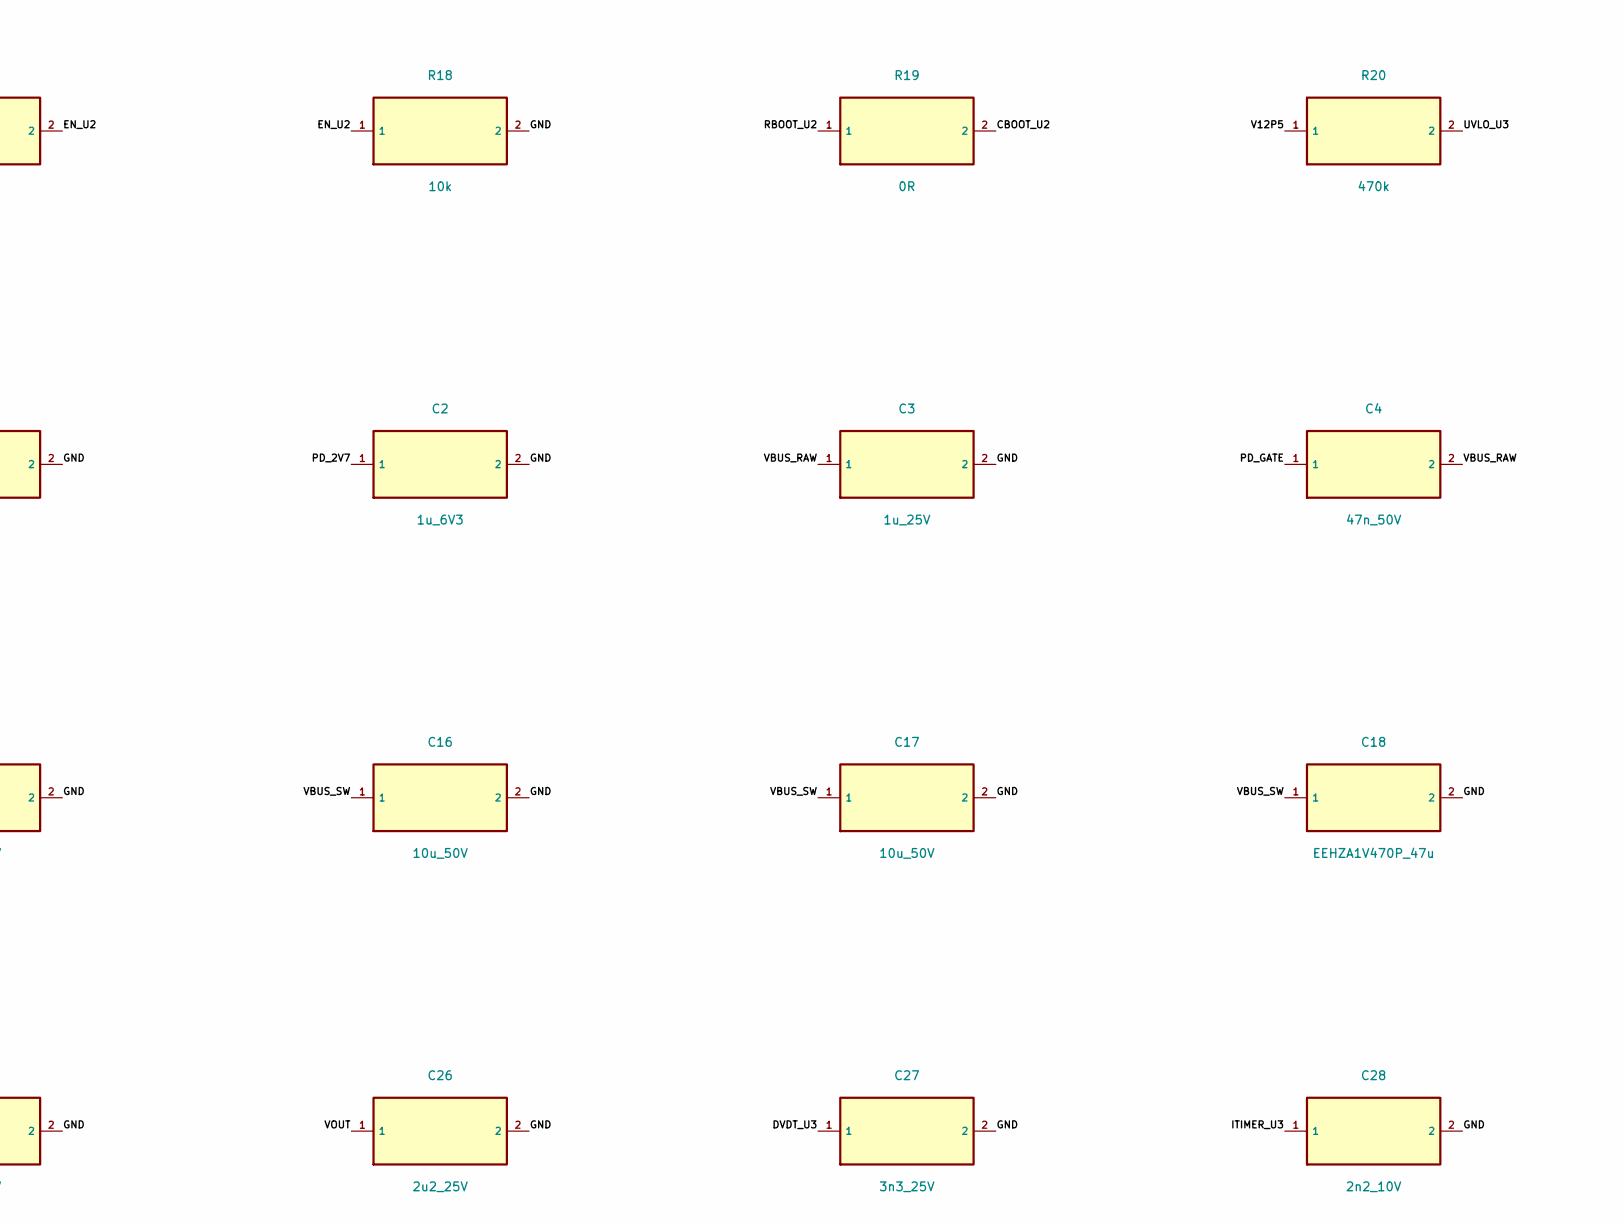
[picture p10: schematic FT2D_PD20V_12V5_3A_评审原理图.kicad_sch, FT2D PD20V to 12.5V/3A - ELECTRICAL REVIEW ONLY, part in row 2, column 3]

Parts:
C1, C2: 1u_6V3; C_0603_1608Metric
C3, C5: 1u_25V; C_0805_2012Metric
C4: 47n_50V; C_0603_1608Metric
C10: 1u_16V; C_0603_1608Metric
C11: 10p_DNP; C_0603_1608Metric; not fitted
C12, C13: 100n_50V; C_0603_1608Metric
C14, C15, C16, C17: 10u_50V; C_1210_3225Metric
C18: EEHZA1V470P_47u; CP_Elec_6.3x5.8
C19: 100n_16V; C_0603_1608Metric
C20, C21, C22, C25: 47u_25V; C_1210_3225Metric
C23: 250AVHT221M0608_220u; CP_Elec_6.3x7.7
C24: 100n_25V; C_0603_1608Metric
C26: 2u2_25V; C_0603_1608Metric
C27: 3n3_25V; C_0603_1608Metric
C28: 2n2_10V; C_0603_1608Metric
D1: ESDA25P35-1U1M; ST_ESDA25P35_1U1M
D2: ESDA25W; SOT-323_SC-70
F1: 1206SFS300F/32; Fuse_1206_3216Metric
J1: TYPE-C-31-M-12; USB_C_Receptacle_HRO_TYPE-C-31-M-12
J2: PD_PROGRAM_TEST; PD_Programming_Pads_1x06_P2p54
J3: E-DC-6_PIGTAIL; Wire_Pads_2x_P3mm
L1: SRG1260-100-M_10uH; JIERR_SRG1260_100M
Q1: STL6P3LLH6; ST_PowerFLAT_3p3_TypeF
R1, R18, R23: 10k; R_0603_1608Metric
R2, R3: 4k7; R_0603_1608Metric
R4: 1k; R_0603_1608Metric
R5: 22k; R_0603_1608Metric
R6: 470R; R_0603_1608Metric
R7, R15, R21, R24: 100k; R_0603_1608Metric
R12: 100k_0.1%; R_0603_1608Metric
R13: 8k66_0.1%; R_0603_1608Metric
R14: 1k_DNP; R_0603_1608Metric; not fitted
R16: 33k2; R_0603_1608Metric
R17: 133k; R_0603_1608Metric
R19: 0R; R_0603_1608Metric
R20: 470k; R_0603_1608Metric
R22: 102k; R_0603_1608Metric
R25: 12k; R_0603_1608Metric
R26: 820R; R_0603_1608Metric
TP1: PG_U3_TEST; TestPoint_Pad_1.0x1.0mm
U1: STUSB4500QTR; QFN-24-1EP_4x4mm_P0.5mm_EP2.7x2.7mm
U2: LM61460AASQRJRRQ1; TI_RJR0014A
U3: TPS259474ARPWR; TI_RPW0010A

Connections:
/BUCK_PGOOD: R15.1, U2.5 (PGOOD)
/BUCK_RT: R16.1, U2.6 (RT)
/BUCK_VCC: C10.1, R15.2, U2.2 (VCC)
/CBOOT_U2: C19.1, R19.2, U2.14 (CBOOT)
/CC1: D2.1 (CC1), J1.A5 (CC1), U1.1 (CC1DB), U1.2 (CC1)
/CC2: D2.2 (CC2), J1.B5 (CC2), U1.4 (CC2), U1.5 (CC2DB)
/CFF_SERIES: C11.1, R14.2
/DVDT_U3: C27.1, U3.7 (DVDT)
/EN_U2: R17.2, R18.1, U2.7 (EN/SYNC)
/FB_U2: C11.2, R12.2, R13.1, U2.4 (FB)
/GND: C1.2, C2.2, C3.2, C5.2, C10.2, C12.2, C13.2, C14.2, C15.2, C16.2, C17.2, C18.2, C20.2, C21.2, C22.2, C23.2, C24.2, C25.2, C26.2, C27.2, C28.2, D1.2, D2.3 (GND), J1.A1 (GND), J1.A12 (GND), J1.B1 (GND), J1.B12 (GND), J1.SH (Shield), J2.1 (GND), J3.2 (GND), R1.2, R13.2, R16.2, R18.2, R21.2, R23.2, R25.2, R26.2, U1.10 (GND), U1.12 (ADDR0), U1.13 (ADDR1), U1.22 (VSYS), U1.25 (EP), U2.1 (BIAS), U2.3 (AGND), U2.9 (PGND1), U2.11 (PGND2), U3.8 (GND)
/ILM_U3: R26.1, U3.9 (ILM)
/ITIMER_U3: C28.1, U3.10 (ITIMER)
/OVLO_U3: R22.2, R23.1, U3.2 (OVLO)
/PD_1V2: C1.1, U1.21 (VREG_1V2)
/PD_2V7: C2.1, J2.4 (2V7_TEST), R2.2, R3.2, U1.23 (VREG_2V7)
/PD_DISCH: R4.1, U1.9 (DISCH)
/PD_GATE: C4.1, Q1.4 (G), R5.2, R7.1
/PD_RESET: J2.6 (RESET), R1.1, U1.6 (RESET)
/PD_VBUS_SENSE: C5.1, R6.1, U1.18 (VBUS_VS_DISCH)
/PGTH_U3: R24.2, R25.1, U3.4 (PGTH)
/PG_U3: TP1.1, U3.3 (PG)
/RBOOT_U2: R19.1, U2.13 (RBOOT)
/SCL: J2.2 (SCL), R2.1, U1.7 (SCL)
/SDA: J2.3 (SDA), R3.1, U1.8 (SDA)
/SW: C19.2, L1.1, U2.10 (SW)
/USB_VBUS: D1.1, F1.1, J1.A4 (VBUS), J1.A9 (VBUS), J1.B4 (VBUS), J1.B9 (VBUS)
/UVLO_U3: R20.2, R21.1, U3.1 (EN/UVLO)
/V12P5: C20.1, C21.1, C22.1, C23.1, C24.1, L1.2, R12.1, R14.1, R20.1, R22.1, R24.1, U3.5 (IN)
/VBUS_EN_SNK: R5.1, U1.16 (VBUS_EN_SNK)
/VBUS_RAW: C3.1, C4.2, F1.2, J2.5 (VBUS_TEST), Q1.1 (S), Q1.2 (S), Q1.3 (S), R6.2, R7.2, U1.24 (VDD)
/VBUS_SW: C12.1, C13.1, C14.1, C15.1, C16.1, C17.1, C18.1, Q1.5 (D), Q1.6 (D), Q1.7 (D), Q1.8 (D), R4.2, R17.1, U2.8 (VIN1), U2.12 (VIN2)
/VOUT: C25.1, C26.1, J3.1 (+12.5V), U3.6 (OUT)

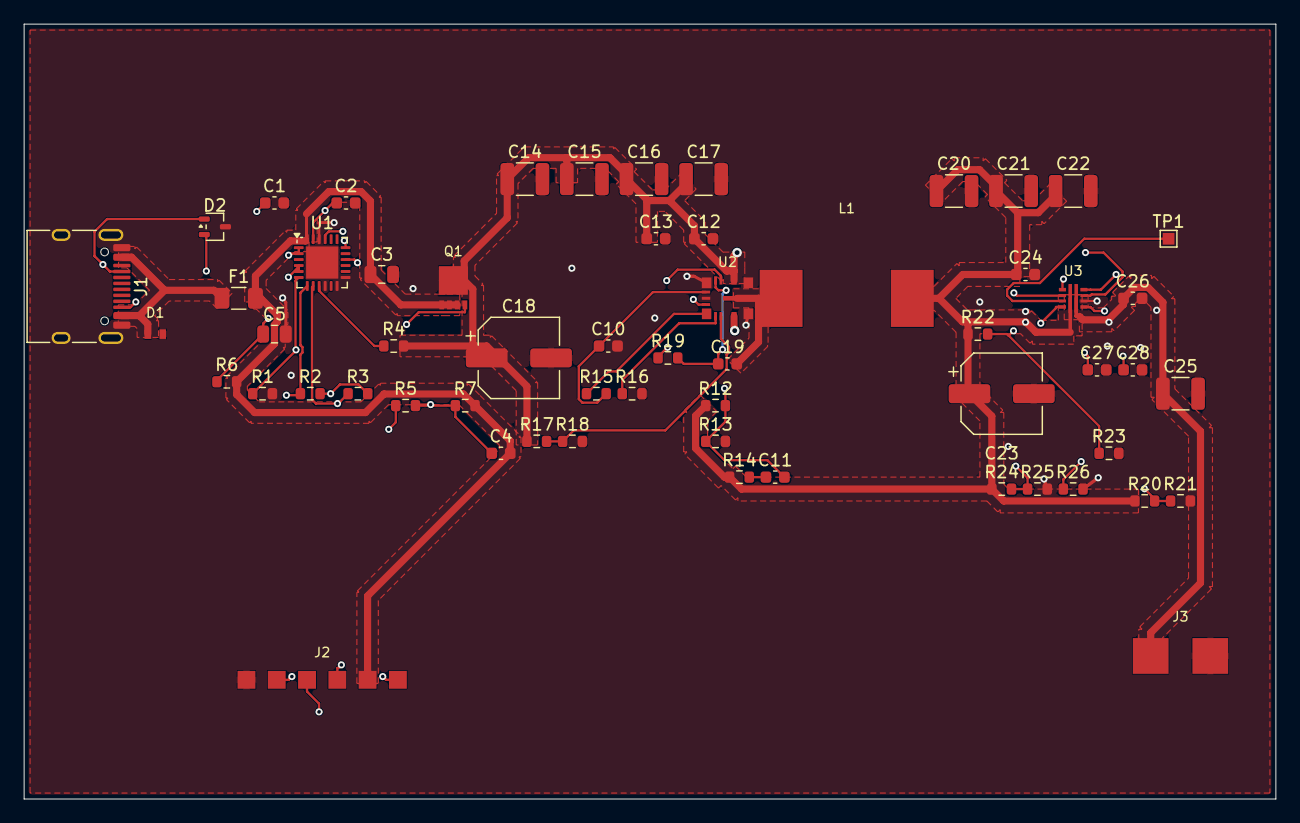
[picture p11: board FT2D_PD20V_12V5_3A_评审原理图.kicad_pcb from above]

Board: 4 copper layers, 105.0 x 65.0 mm, 58 parts (0 on the bottom side), 33 nets.
