Accelerator6666/Yaesu-FT2D-USBC-charge/(commit log)

2026-10-25 Add FT2D USB-C PD adapter KiCad engineering project
    [FT2D_PD20V_12V5_3A_BOM.csv, FT2D_PD20V_12V5_3A_原型板.kicad_pcb, FT2D_PD20V_12V5_3A_评审原理图.kicad_pcb, FT2D_PD20V_12V5_3A_评审原理图.kicad_sch]
2026-10-25 Document PCB DRC blockers and first-board fabrication gates
2026-10-25 Add JLCPCB Rev B PCB WIP, DRC/ERC reports and SMT sourcing previews (NO-GO)
    [FT2D_PD20V_12V5_3A_评审原理图.kicad_pcb, FT2D_PD20V_12V5_3A_评审原理图.kicad_sch, FT2D_RevB_SMT_sourcing_DRAFT.xlsx, kicad_bom_unverified.csv, kicad_positions_unverified.csv]
2026-10-26 Rev B: verify JLC SMT J1/L1, tighten buck routing and audit 3A/GND (NO-GO)
    [FT2D_PD20V_12V5_3A_评审原理图.kicad_pcb, FT2D_PD20V_12V5_3A_评审原理图.kicad_sch, FT2D_RevB_SMT_sourcing_DRAFT.xlsx, kicad_bom_unverified.csv, kicad_positions_unverified.csv]
2026-10-26 Rev B: clear ERC/DRC/GND, validate C18 JLC hybrid footprint, export QA Gerbers and SMT sourcing review (NO-GO)
    [FT2D_PD20V_12V5_3A_评审原理图-B_Cu.gbl, FT2D_PD20V_12V5_3A_评审原理图-B_Mask.gbs, FT2D_PD20V_12V5_3A_评审原理图-B_Paste.gbp, FT2D_PD20V_12V5_3A_评审原理图-B_Silkscreen.gbo, FT2D_PD20V_12V5_3A_评审原理图-Edge_Cuts.gm1, FT2D_PD20V_12V5_3A_评审原理图-F_Cu.gtl, FT2D_PD20V_12V5_3A_评审原理图-F_Mask.gts, FT2D_PD20V_12V5_3A_评审原理图-F_Paste.gtp]
2026-10-26 Harden JLCPCB SMT release gate with 53-designator BOM/CPL consistency checks
2026-10-26 Rev B: map 53 SMT candidate C-codes and audit power copper necks (NO-GO)
    [FT2D_RevB_SMT_sourcing_DRAFT.xlsx, JLC_CANDIDATE_BOM_NOT_APPROVED.csv, SMT_CANDIDATE_TRACEABILITY_NOT_APPROVED.csv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]
2026-10-26 Rev B: stitch U3 power copper and upgrade output bypass; refresh JLC review QA (NO-GO)
    [FT2D_PD20V_12V5_3A_评审原理图-B_Cu.gbl, FT2D_PD20V_12V5_3A_评审原理图-B_Mask.gbs, FT2D_PD20V_12V5_3A_评审原理图-B_Paste.gbp, FT2D_PD20V_12V5_3A_评审原理图-B_Silkscreen.gbo, FT2D_PD20V_12V5_3A_评审原理图-Edge_Cuts.gm1, FT2D_PD20V_12V5_3A_评审原理图-F_Cu.gtl, FT2D_PD20V_12V5_3A_评审原理图-F_Mask.gts, FT2D_PD20V_12V5_3A_评审原理图-F_Paste.gtp]
2026-10-26 Rev B: package JLC quote/SMT preview files and document PD NVM & 3A screening (NO-GO)
    [FT2D_RevB_JLC_BOM_QUOTE_ONLY_NOT_APPROVED.csv, kicad_native_smt_positions.csv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]
2026-10-26 Rev B: qualify JLC SMT 102k OVLO resistor and refresh fab preview artifacts (NO-GO)
    [FT2D_PD20V_12V5_3A_评审原理图.kicad_pcb, FT2D_PD20V_12V5_3A_评审原理图.kicad_sch, FT2D_RevB_JLC_BOM_QUOTE_ONLY_NOT_APPROVED.csv, FT2D_RevB_SMT_sourcing_DRAFT.xlsx, JLC_CANDIDATE_BOM_NOT_APPROVED.csv, SMT_CANDIDATE_TRACEABILITY_NOT_APPROVED.csv, kicad_bom_unverified.csv, kicad_native_smt_positions.csv]
2026-10-26 Rev P: design protected USB-C PD module and perfboard FT2D prototype
2026-10-26 Rev P-D: use TA3005U 12V/3A PDO directly with independent OVP; retain buck fallback
2026-10-26 Rev P-D: lock affordable PD trigger, OVP and ATO fuse BOM with assembly gates
